geirivtu/NRWD/tmp/vedlegg_nordal_pdcp/test/README.txt

This directory is for unit testing of software modules.
Will not compile on AVR.
