geirivtu/NRWD/doc/notater.txt

Notater av Geir Turtum om NRWD(NTNU Rotation Wrist Device/Norwegian Regent Waving Device)

Kandidater til utviklingsmetodikk
- Top Down Design
