geirivtu/NRWD/doc/Prosjektoppgave/CD/Rapport/Figurer/code_class_diagram.pdf

PDCP representerer
alle filene som
implementerer
protokollen

Diagrammet viser
alle kode modulene
og sammenhengen
mellom de. MAIN

can.h
bool can_init()
can_tx(char, CAN_packet)
prepare_rx(..)

PDCP

analog.h
void analog_init()

motor.h
void motor_init()
void motor_start()
void motor_stop()
void motor_set_speed()
void motor_read_speed()
ISR(TIMER0_OVF_vect)
ISR(HALL_[A,B,C]_vect)

controlller.h
#define TIMESTEP 150

void control_on_off()
void control_position()
void control_speed()
void control_set_setpoint(int16_t) void control_set_parameter(double)

position.h
void position_init()
int16_t position_get()

current.h
#define CURRENT_MAX 145

void current_init()
int16_t current_get()
