geirivtu/NRWD/doc/Kraakenes2011/Rapport/figurer/kapittel 2/kommutering med hall-sensorer.pdf

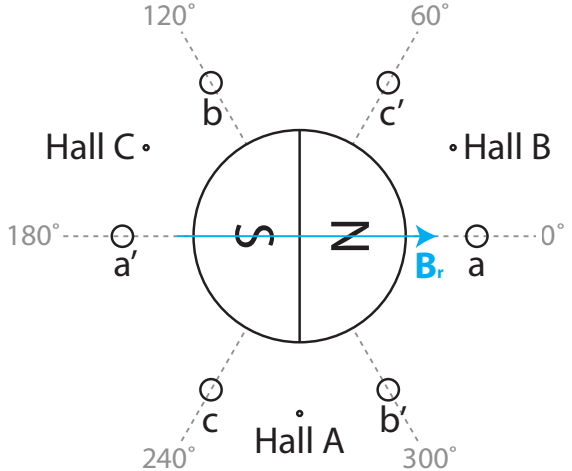
[picture p44: figure]
Hall C; Hall A; Hall B
