geirivtu/NRWD/doc/Kraakenes2011/Rapport/figurer/kapittel 2/motor med hall-sensorer.pdf

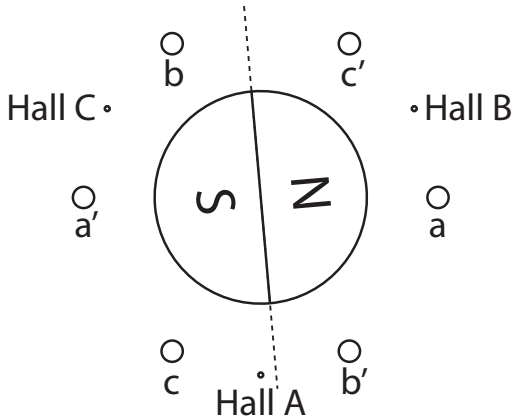
[picture p45: figure]
Hall C; Hall A; Hall B
