geirivtu/NRWD/doc/Kraakenes2011/Rapport/figurer/kapittel 4/arkitektur_maksin.pdf

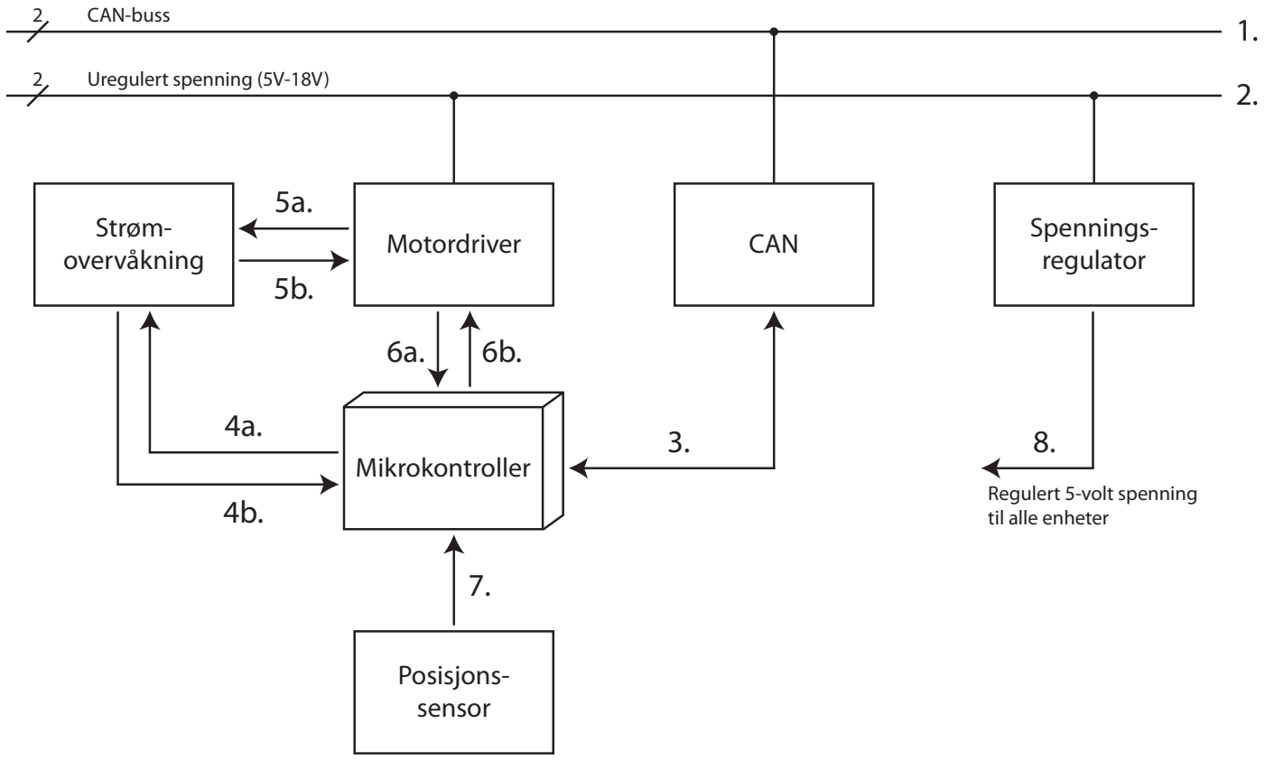
[picture p46: figure]
Spennings- regulator; Strøm-; overvåkning; Motordriver; CAN; Posisjons- sensor; CAN-buss; Uregulert spenning (5V-18V); Mikrokontroller; Regulert 5-volt spenning til alle enheter
