geirivtu/NRWD/doc/Kraakenes2011/Rapport/figurer/kapittel 4/arkitektur_program.pdf

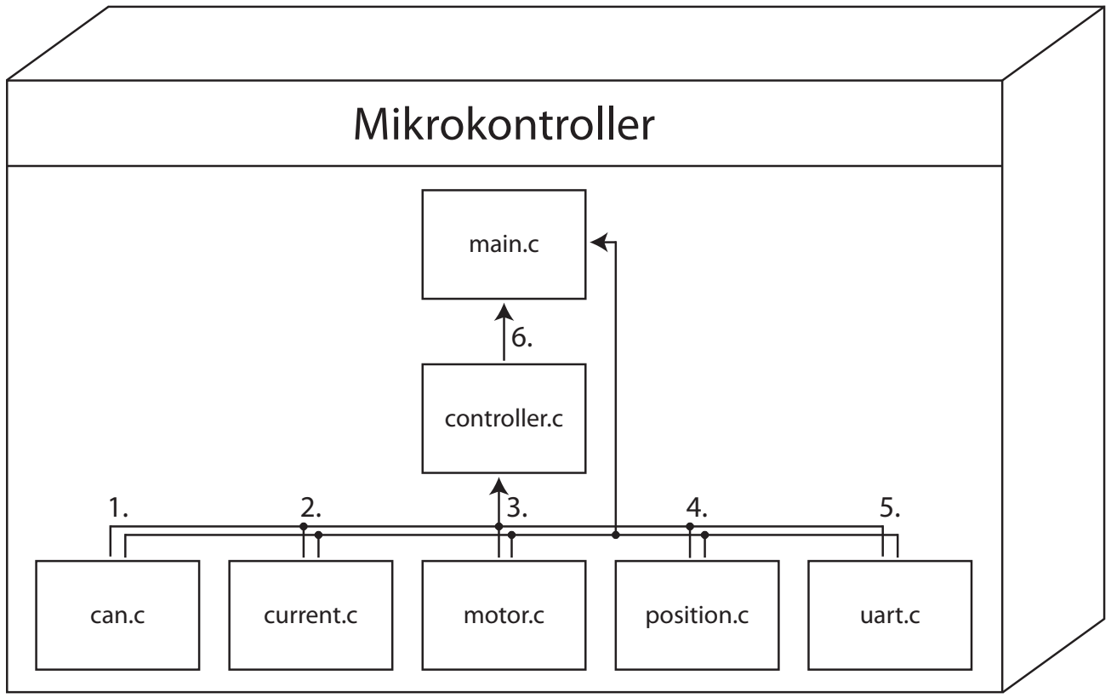
[picture p47: figure]
Mikrokontroller; can.c; current.c; motor.c; position.c; uart.c; controller.c; main.c
