geirivtu/NRWD/doc/Kraakenes2011/Rapport/figurer/kapittel 4/skisse snitt.pdf

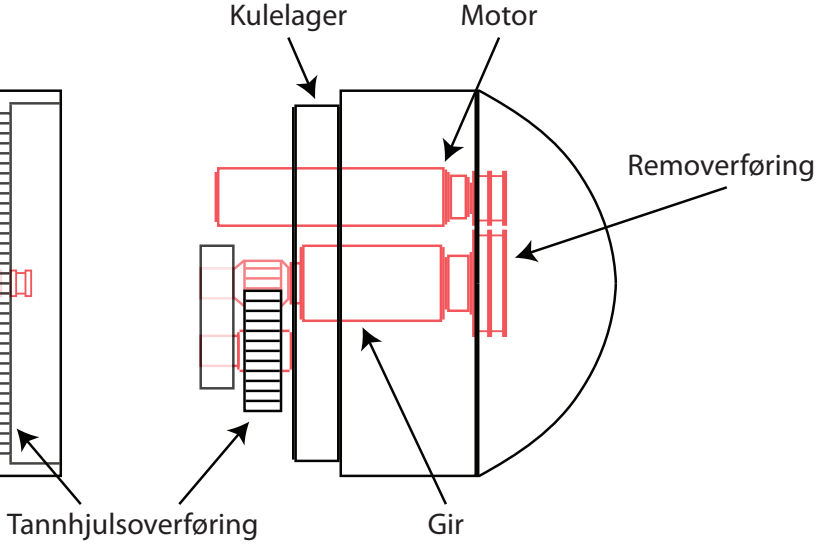
[picture p48: figure]
Motor; Removerføring; Tannhjulsoverføring; Gir; Kulelager
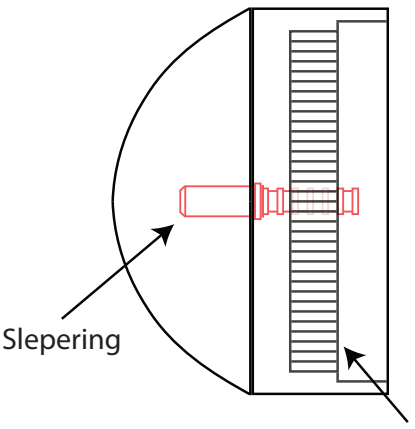
[picture p49: figure]
Slepering
