geirivtu/NRWD/doc/Kraakenes2011/Rapport/figurer/kapittel 5/krets spenning.pdf

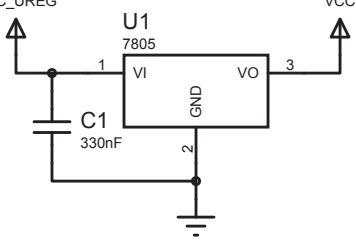
[picture p50: figure]
GND 2

VCC_UR

E

G | VC C
