geirivtu/NRWD/doc/Kraakenes2011/Rapport/figurer/kapittel 6/kommunikasjonsdiagram.pdf

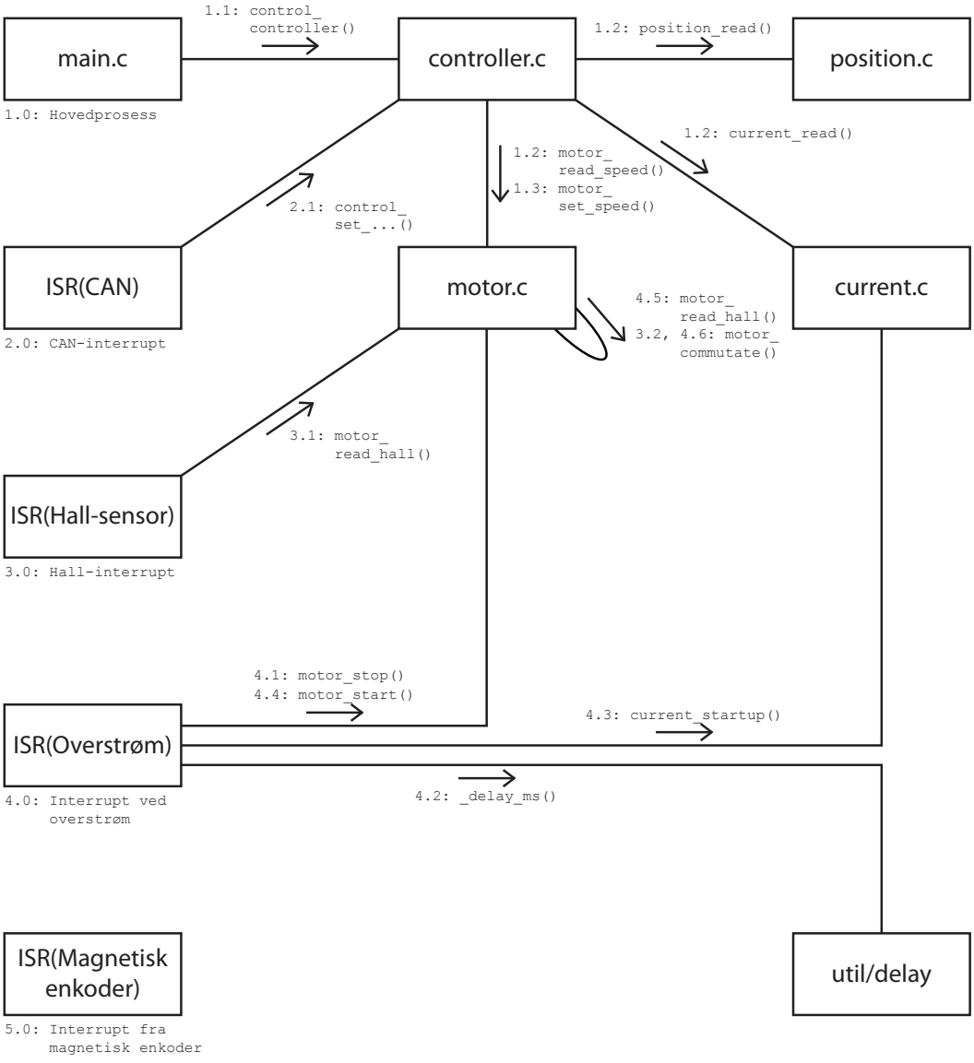
[picture p51: figure]
main.c; ISR(CAN); ISR(Overstrøm); ISR(Magnetisk enkoder); controller.c; position.c; motor.c; current.c; ISR(Hall-sensor); 4.1: motor_stop() 4.4: motor_start(); 1.1: control_ controller(); 3.1: motor_ read_hall(); 4.3: current_startup(); 1.2: position_read(); 1.2: current_read(); 1.2: motor_ read_speed() 1.3: motor_; 2.1: control_; set_speed(); set_...(); 4.2: _delay_ms(); 4.5: motor_ read_hall() 3.2, 4.6: motor_ commutate(); util/delay; 1.0: Hovedprosess; 2.0: CAN-interrupt; 3.0: Hall-interrupt; 4.0: Interrupt ved overstrøm; 5.0: Interrupt fra magnetisk enkoder

### ISR(Motorhastighet)

6.0: Interrupt ved beregning av motorhastighet
