geirivtu/NRWD/doc/Kraakenes2011/Rapport/figurer/kapittel 6/sekvens interrupt can.pdf

CAN-interrupt

main.c | controller.c

## control_ set_mode()

## control_ set_setpoint()

## control_ set_parameter()

[MSG_ID = ID_CONTROLLER]

[MSG_ID = ID_SETPOINT]

[MSG_ID = ID_PARAMETER]

## alt
