geirivtu/NRWD/doc/Kraakenes2011/Rapport/figurer/kapittel 6/sekvens interrupt current.pdf

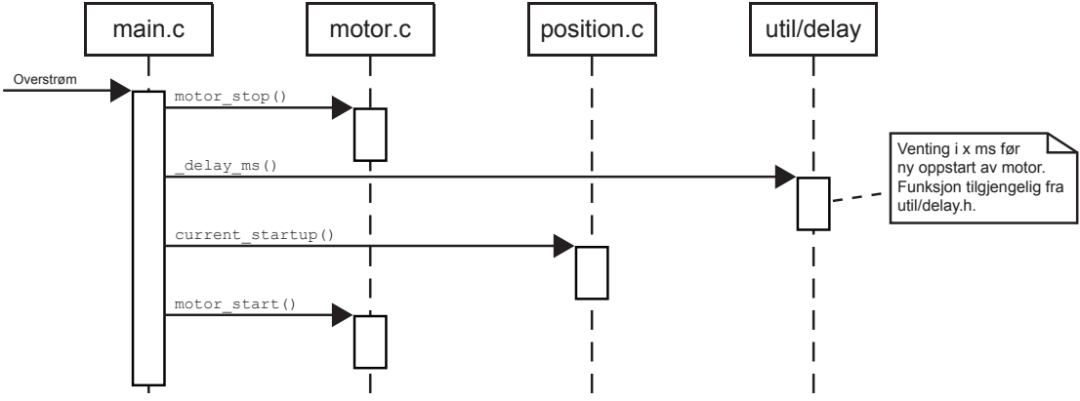
[picture p52: figure]
main.c; motor.c; position.c; Overstrøm; motor_stop(); current_startup(); motor_start(); util/delay; _delay_ms(); Venting i x ms før ny oppstart av motor. Funksjon tilgjengelig fra util/delay.h.
