geirivtu/NRWD/doc/Kraakenes2011/Rapport/figurer/kapittel 6/sekvens interrupt motor.pdf

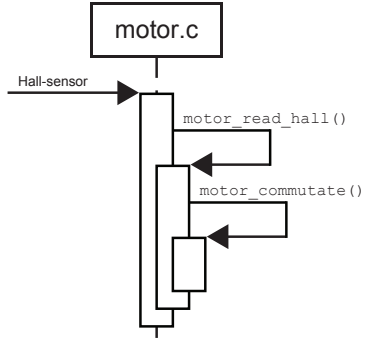
[picture p53: figure]
motor.c; motor_commutate(); motor_read_hall(); Hall-sensor
