geirivtu/NRWD/doc/Kraakenes2011/Rapport/figurer/kapittel 6/sekvensdiagram.pdf

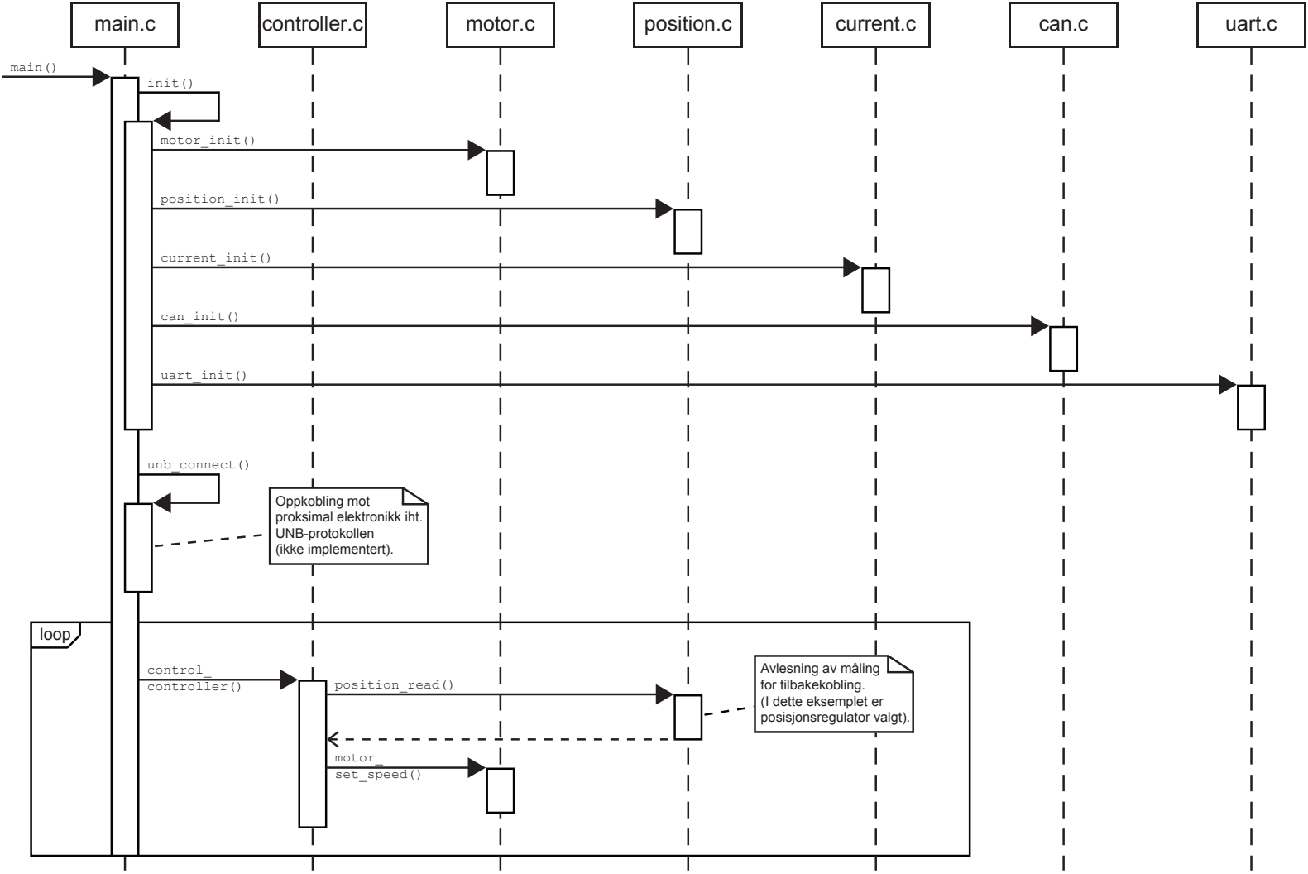
[picture p54: figure]
uart.c; main(); uart_init(); can_init(); current_init(); position_init(); motor_init(); init(); control_; controller(); position_read(); motor_ set_speed(); loop; unb_connect(); Oppkobling mot proksimal elektronikk iht. UNB-protokollen (ikke implementert).; Avlesning av måling for tilbakekobling. (I dette eksemplet er posisjonsregulator valgt).

main.c | controller.c | motor.c | position.c | current.c | can.c
