geirivtu/NRWD/doc/Kraakenes2011/Rapport/figurer/kapittel 2/ideell kommutering.pdf

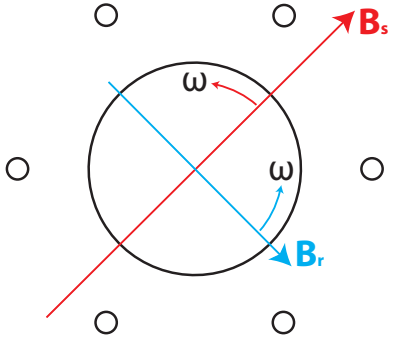
[picture p123: figure]
