geirivtu/NRWD/doc/Kraakenes2011/Rapport/figurer/kapittel 2/kommutering med motindusert spenning.pdf

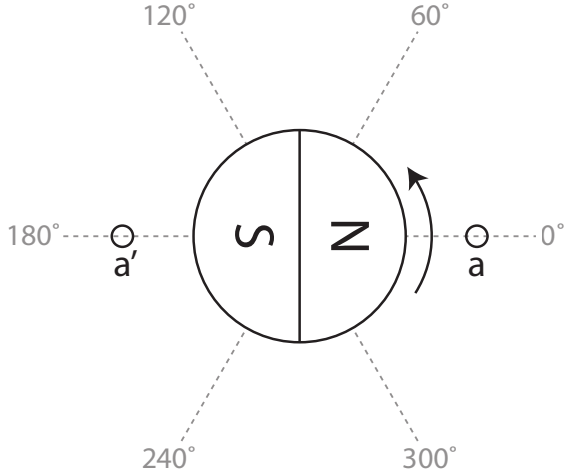
[picture p124: figure]
