geirivtu/NRWD/doc/Kraakenes2011/Rapport/figurer/kapittel 2/stjernekobling.pdf

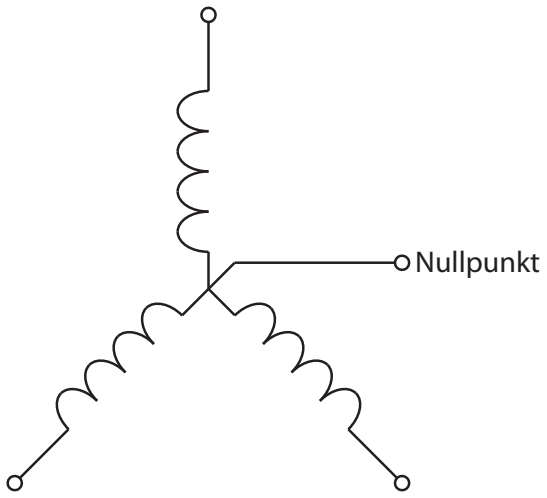
[picture p125: figure]
Nullpunkt

A | B

C
