geirivtu/NRWD/doc/Kraakenes2011/Rapport/figurer/kapittel 2/trefase med en aktiv spole.pdf

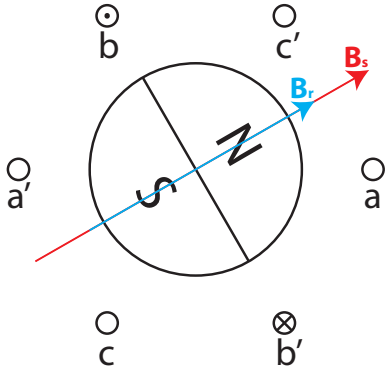
[picture p126: figure]
