geirivtu/NRWD/doc/Kraakenes2011/Rapport/figurer/kapittel 2/trefase med to aktive spoler.pdf

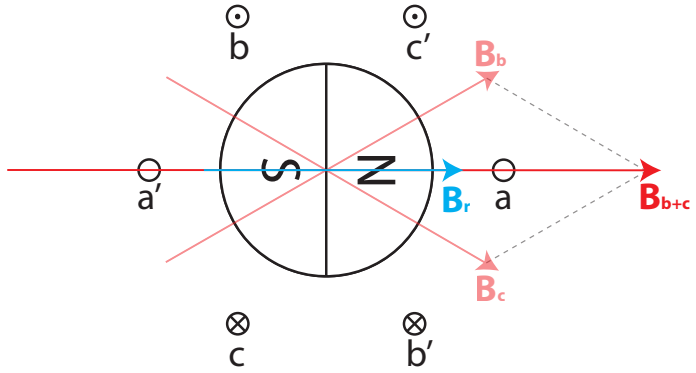
[picture p127: figure]
