geirivtu/NRWD/doc/Kraakenes2011/Rapport/figurer/kapittel 2/trefase.pdf

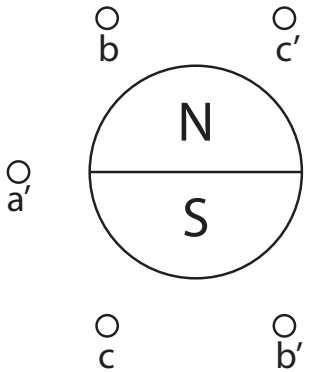
[picture p128: figure]

a
