geirivtu/NRWD/doc/Kraakenes2011/Rapport/figurer/kapittel 4/handledd.pdf

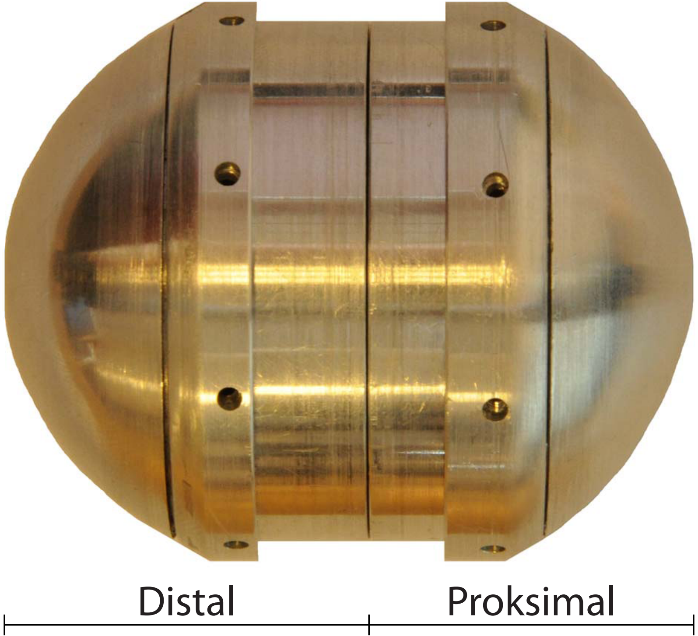
[picture p129: page 1]

Distal | Proksimal
