geirivtu/NRWD/doc/Kraakenes2011/Rapport/figurer/kapittel 5/krets can.pdf

C

A

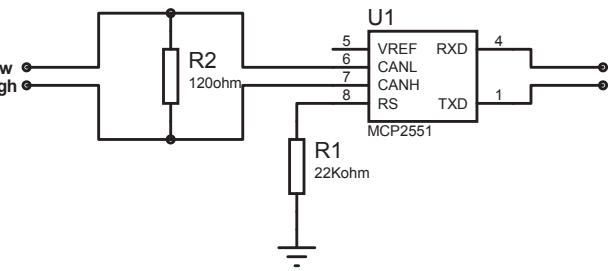
[picture p130: figure]
VRE; CAN; TXD; U1 MCP2551

### N Hig

C

A

### N Lo

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
