geirivtu/NRWD/doc/Kraakenes2011/Rapport/figurer/kapittel 5/krets posisjon.pdf

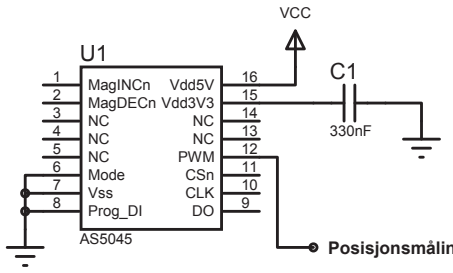
[picture p131: figure]
Mag; INC; Vdd3V3; 15 Vdd5V; MagDEC; Mode; Prog_D; C1 330nF Posis; jons; åli

n

g
