geirivtu/NRWD/doc/Kraakenes2011/Rapport/figurer/vedlegg/magnetholder.pdf

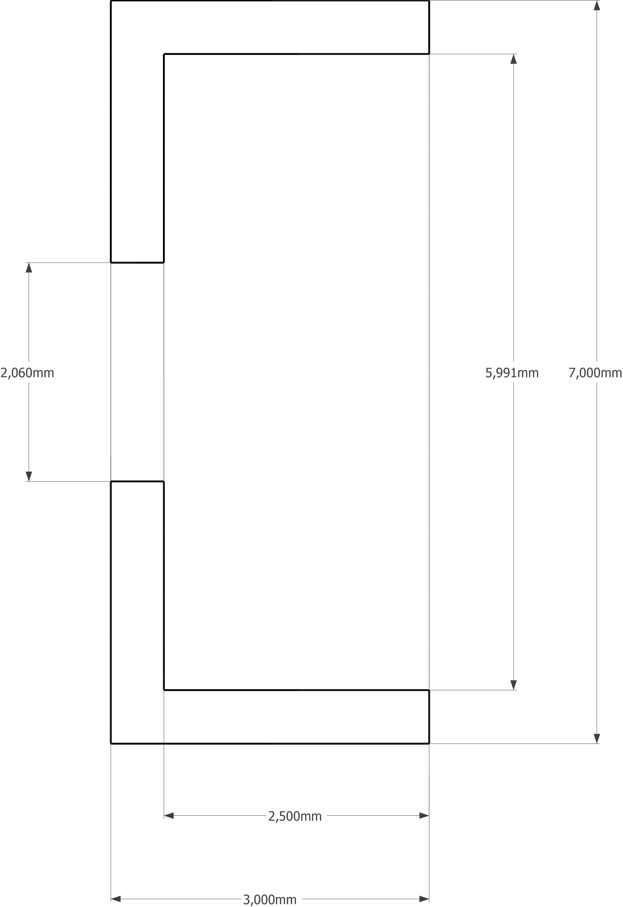
[picture p132: figure]
