geirivtu/NRWD/doc/Storheil.Rainer2005.pdf

NTNU | Fakultet for informasjonsteknologi,
Norges teknisk-naturvitenskapelige | matematikk og elektroteknikk
universitet | Institutt for teknisk kybernetikk

## Prosjektoppgave

Utført ved Institutt for teknisk kybernetikk Veileder: Øyvind Stavdahl

Trondheim, den 17.06.2005

Faglærer: Geir Mathisen

Kandidatens navn: | Rainer Storheil
Fag: | TTK4720 Navigasjon, fartøystyring og robotteknikk, fordypningsemne, Teknisk Kybernetikk
Oppgavens tittel: | Innvevd programvare for kybernetisk håndleddsprotese
Oppgavens tekst: | Forskning har frembrakt ny teoretisk viten om hvordan en motorisert håndleddsprotese bør utformes for å tilby brukeren maksimal nytteverdi. En ønsker å lage en fysisk protese etter disse prinsippene for å evaluere den reelle nytten. Protesen vil ha et mikrokontrollerbasert styresystem, og målet for denne oppgaven er å utvikle og realisere programvaren for systemet basert på en foreliggende funksjonsspesifikasjon.
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
