geirivtu/NRWD/doc/Data/position_sensor_output/max_degree_zomed_in.png

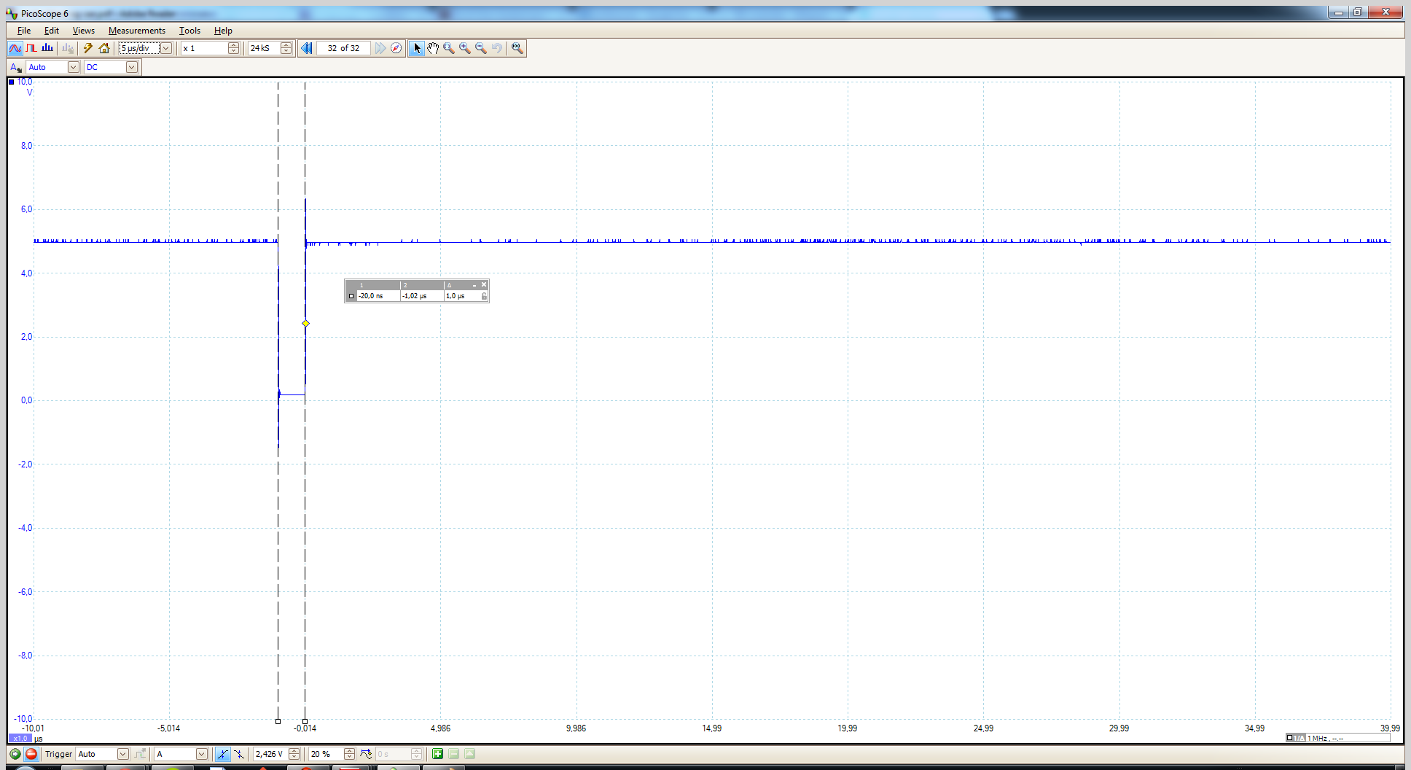
doc/Data/position_sensor_output/max_degree_zomed_in.png
