geirivtu/NRWD/doc/Data/position_sensor_output/min_degree.png

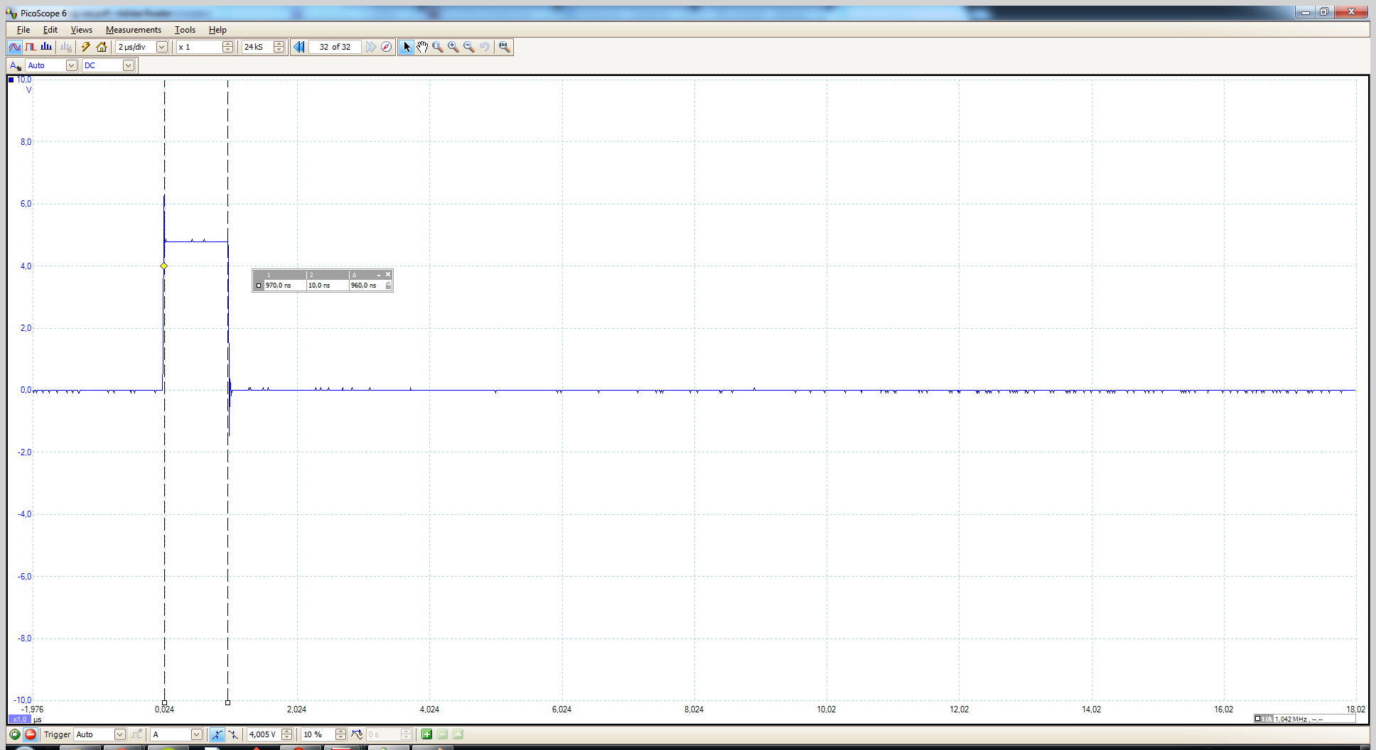
doc/Data/position_sensor_output/min_degree.png
