geirivtu/NRWD/doc/Data/position_sensor_output/whole_period.png

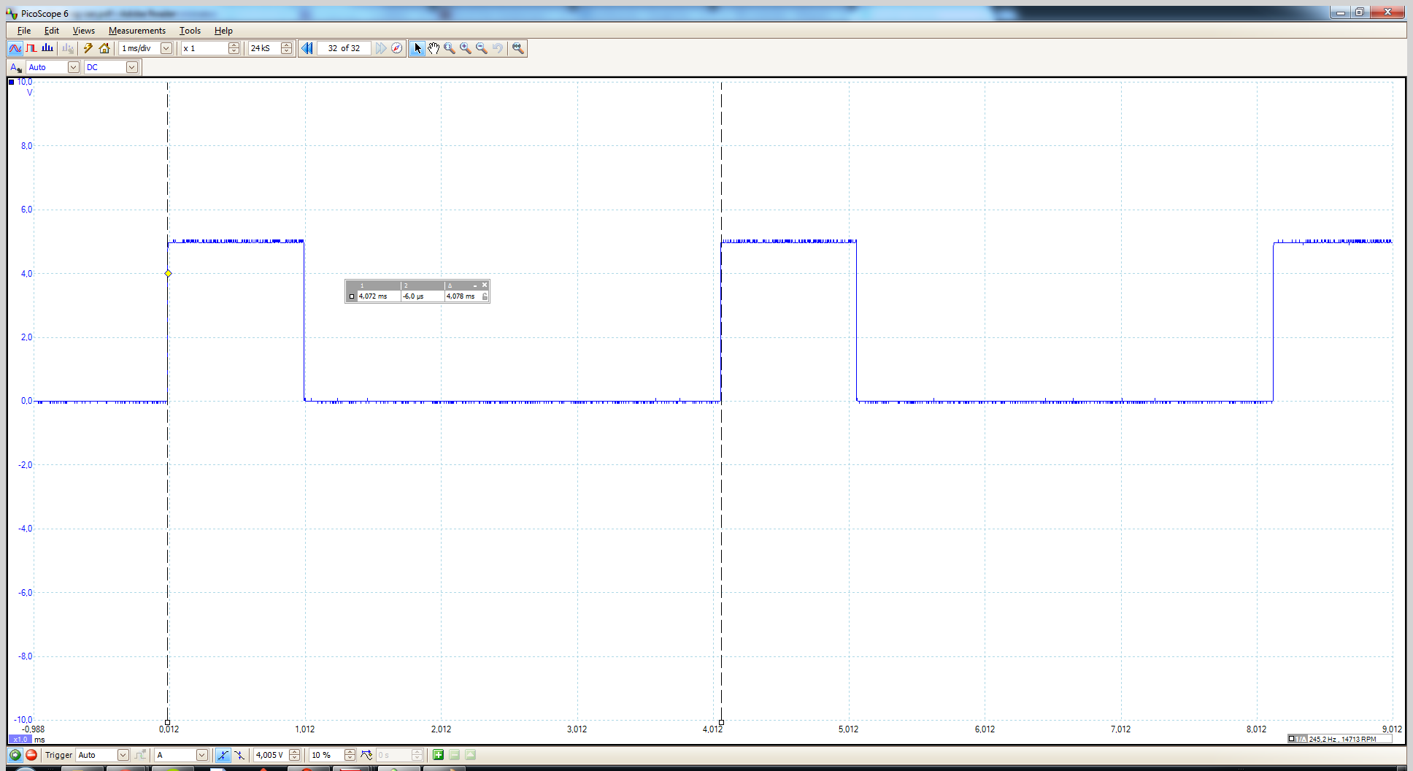
doc/Data/position_sensor_output/whole_period.png
