geirivtu/NRWD/doc/Kraakenes2011/Rapport/figurer/kapittel 6/mikrokontroller.JPG

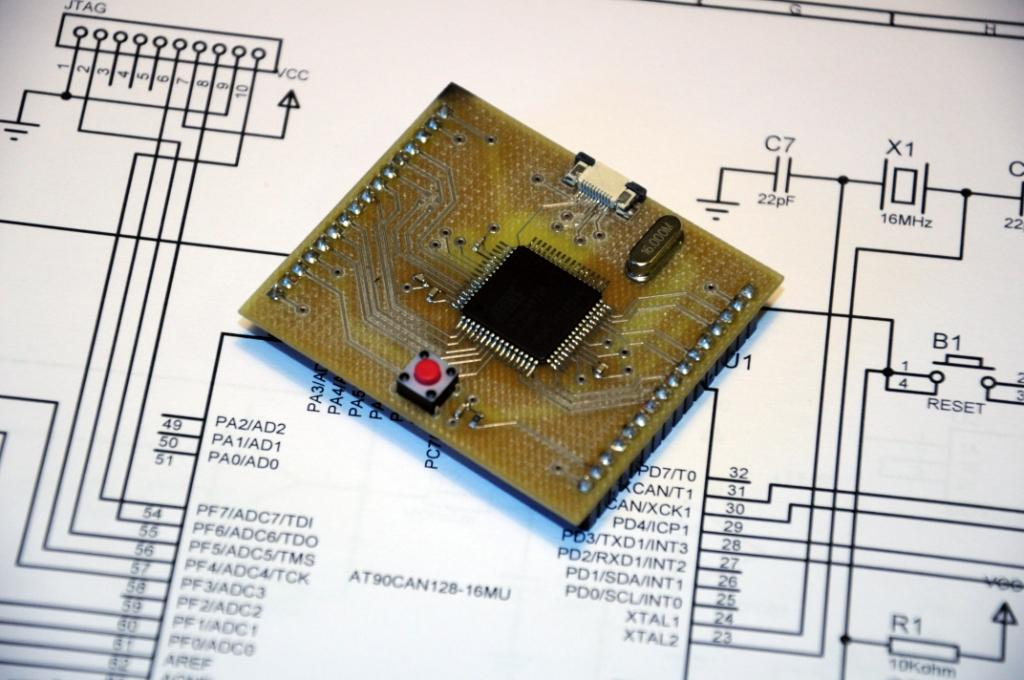
doc/Kraakenes2011/Rapport/figurer/kapittel 6/mikrokontroller.JPG
