geirivtu/NRWD/doc/Kraakenes2011/Rapport/figurer/kapittel 6/motor can.JPG

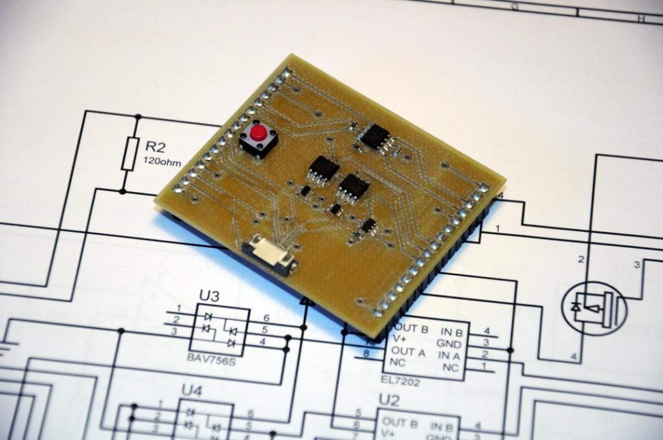
doc/Kraakenes2011/Rapport/figurer/kapittel 6/motor can.JPG
