geirivtu/NRWD/doc/Kraakenes2011/Rapport/figurer/kapittel 6/posisjonssensor håndledd.JPG

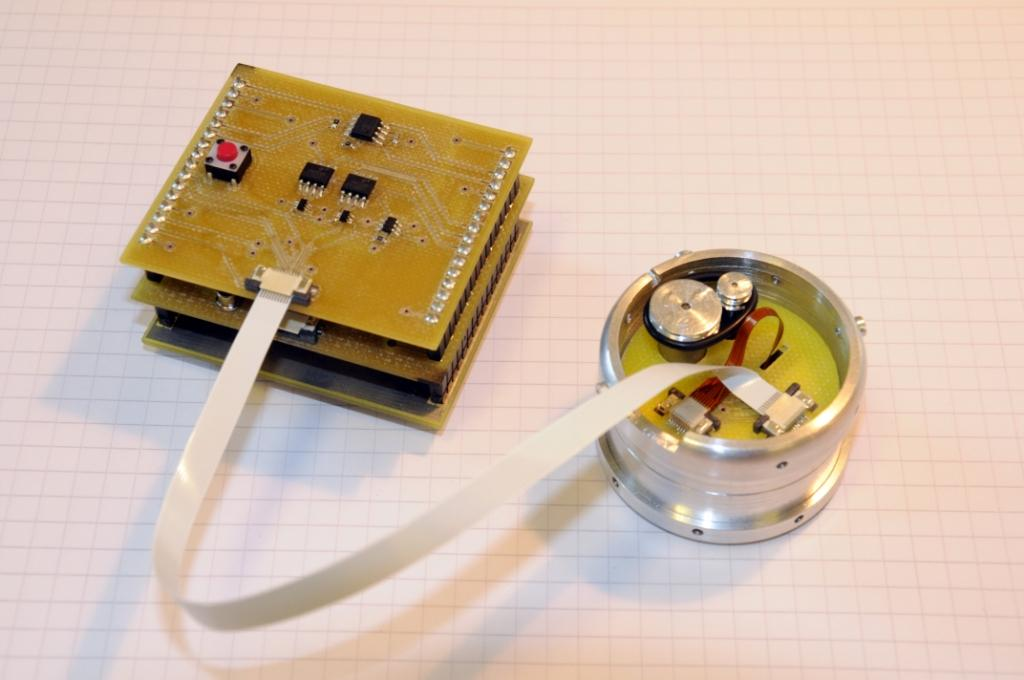
doc/Kraakenes2011/Rapport/figurer/kapittel 6/posisjonssensor håndledd.JPG
