geirivtu/NRWD/doc/Kraakenes2011/Rapport/figurer/kapittel 6/posisjonssensor.JPG

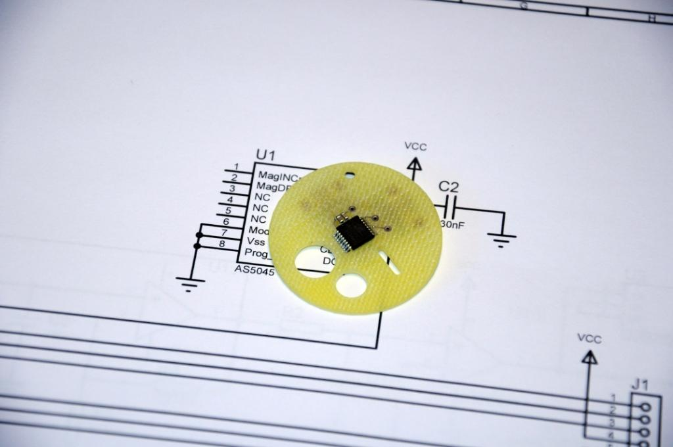
doc/Kraakenes2011/Rapport/figurer/kapittel 6/posisjonssensor.JPG
