geirivtu/NRWD/doc/Kraakenes2011/Rapport/figurer/kapittel 6/spenningsregulator.JPG

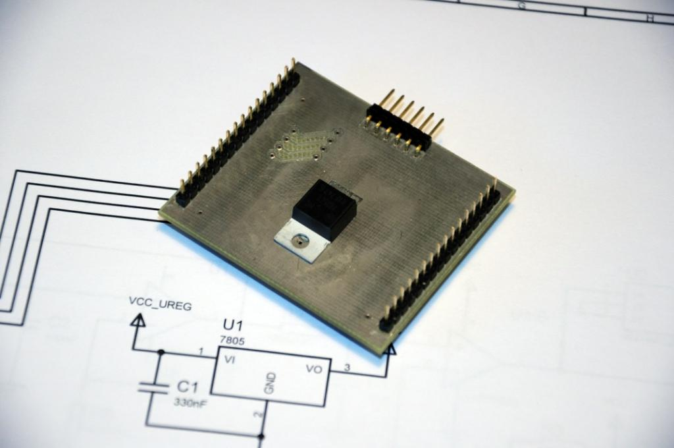
doc/Kraakenes2011/Rapport/figurer/kapittel 6/spenningsregulator.JPG
