geirivtu/NRWD/doc/Kraakenes2011/Rapport/figurer/kapittel 6/strømovervåkning.JPG

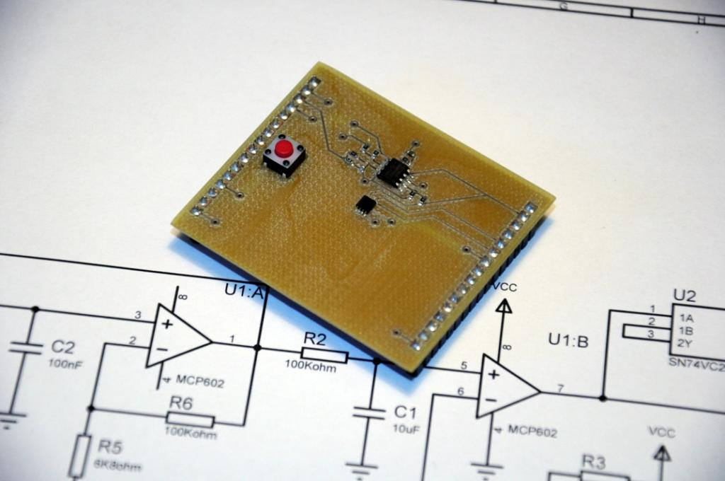
doc/Kraakenes2011/Rapport/figurer/kapittel 6/strømovervåkning.JPG
