geirivtu/NRWD/tmp/vedlegg_nordal_pdcp/doxy-src/interface.png

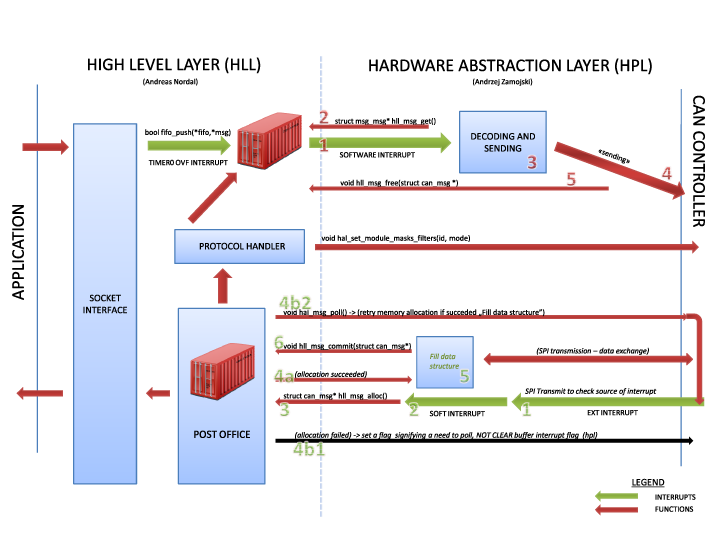
tmp/vedlegg_nordal_pdcp/doxy-src/interface.png
