geirivtu/NRWD/tmp/vedlegg_nordal_pdcp/doxy-src/msgReceiving.png

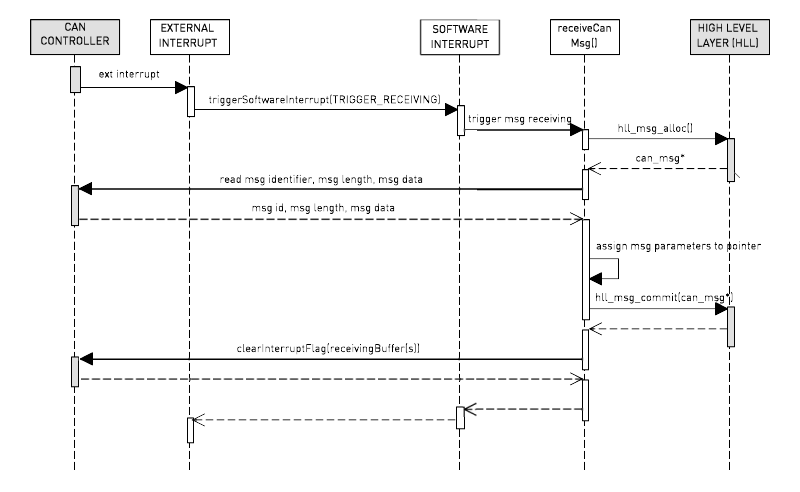
tmp/vedlegg_nordal_pdcp/doxy-src/msgReceiving.png
