geirivtu/NRWD/tmp/vedlegg_nordal_pdcp/doxy-src/msgSending.png

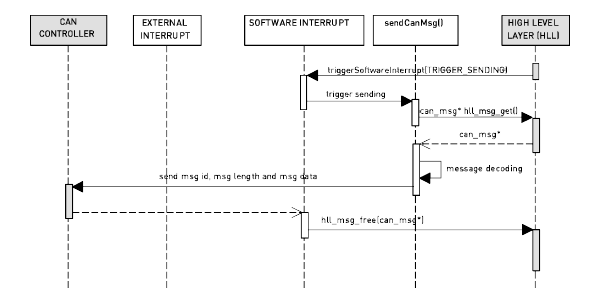
tmp/vedlegg_nordal_pdcp/doxy-src/msgSending.png
