geirivtu/NRWD/tmp/vedlegg_nordal_pdcp/doxy-src/pcbBoard_blockDiagram.png

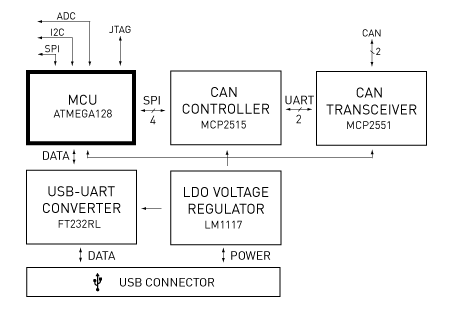
tmp/vedlegg_nordal_pdcp/doxy-src/pcbBoard_blockDiagram.png
