geirivtu/NRWD/(list of files, cad)

Other CAD files:
doc/Kraakenes2011/3D-modell/magnetholder.skp
