geirivtu/NRWD/sw/nrwd_test/pdcp/List_of_functions_to_change.txt

functions.c
	-initCan( uint8_t id);
	-hal_set_filter(id);
	-hal_set_mask(id);
	
irqhandlers.c
	-ISR ( CONFIG_INT_SENDING ) 
	-receiveCanMsg ( uint8_t regRec );
	-sendCanMsg ( struct can_msg* msgToSend, uint8_t regToSend );
