geirivtu/NRWD/doc/Kraakenes2011/Rapport/figurer/kapittel 5/krets motor.pdf

U1
U3

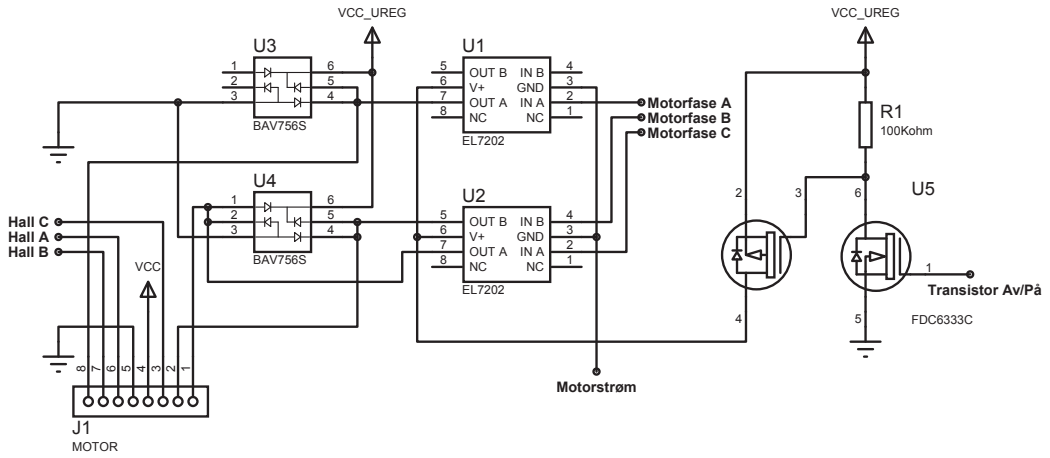
[picture p146: page 1]
1 OUT A 7; 2 GND; 4 OUT B 5; BAV756S; VCC_UREG; Motorfase A; Hall C Hall A Hall B; Motorfase B Motorfase C; J1 MOTOR; FDC6333C; R1 100Kohm; Transistor Av/På; Motorstrøm; VCC
