geirivtu/NRWD/doc/Kraakenes2011/Rapport/figurer/vedlegg/krets motordriver og can.pdf

U5
R2

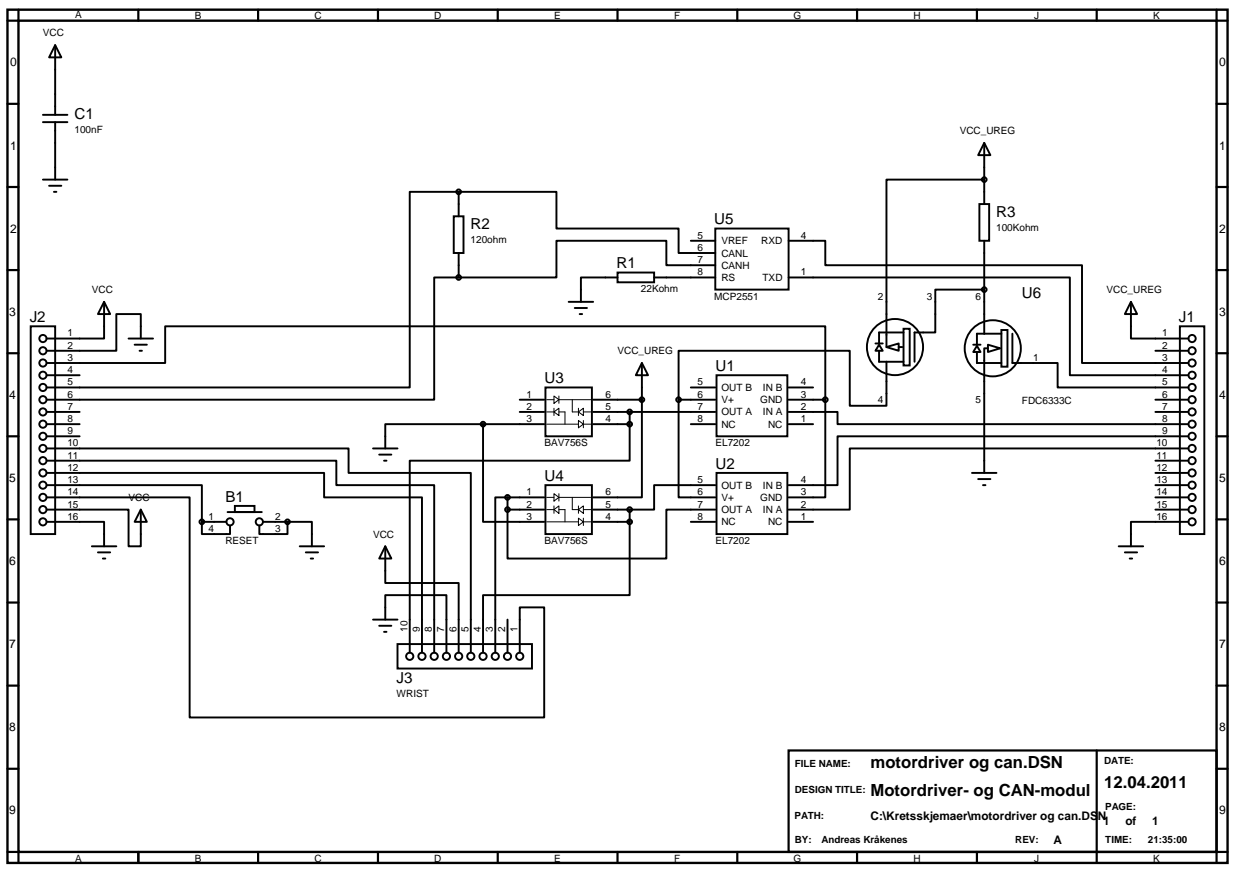
[picture p147: page 1]

motordriver og can.DSN FILE NAME: DESIGN TITLE: Motordriver- og CAN-modul C:\Kretsskjemaer\motordriver og can.DSN1 of 1 BY: Andreas Kråkenes REV: A | DATE: 12.04.2011 PAGE: TIME: 21:35:00 | 9 PATH:
