geirivtu/NRWD/doc/Kraakenes2011/Rapport/figurer/vedlegg/krets posisjonsmåling.pdf

C1

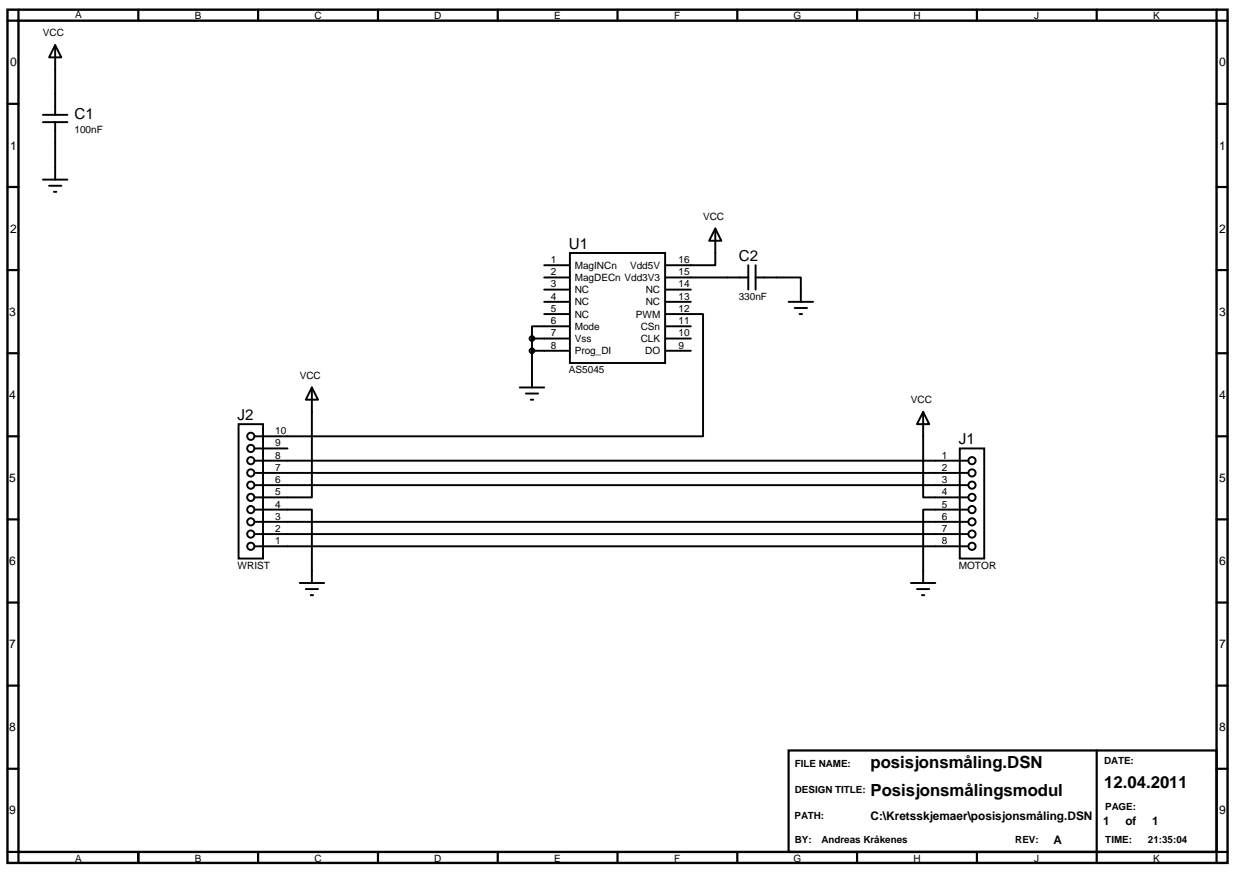
[picture p148: page 1]
MagINCn 1; Vdd3V3; 15 Vdd5V; 14 MagDECn 2; NC 5 Mode 6 Vss 7 Prog_DI 8; CSn; 11 PWM; CLK; VCC; WRIST; MOTOR

0 | | VCC | 0

posisjonsmåling.DSN FILE NAME: DESIGN TITLE: Posisjonsmålingsmodul C:\Kretsskjemaer\posisjonsmåling.DSN BY: Andreas Kråkenes REV: A | DATE: 12.04.2011 PAGE: 1 of 1 TIME: 21:35:04 | 9 PATH:
