geirivtu/NRWD/doc/Kraakenes2011/Rapport/figurer/vedlegg/krets spenningsregulator.pdf

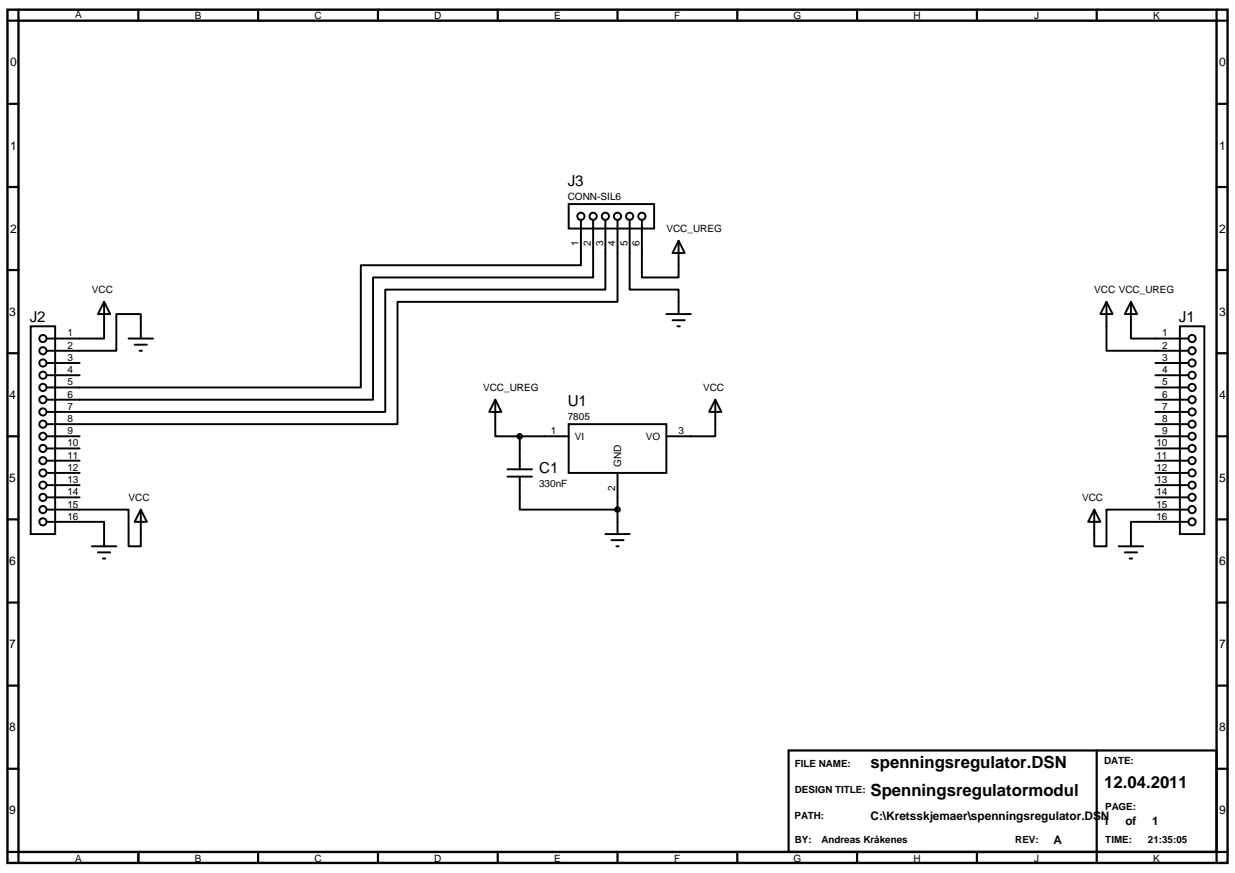
[picture p149: page 1]
VCC; VCC VCC_UREG; GND; VCC_UREG

0 | J3 CONN-SIL6 | | | | | | | | | | 0

spenningsregulator.DSN FILE NAME: DESIGN TITLE: Spenningsregulatormodul C:\Kretsskjemaer\spenningsregulator.DSN1 of 1 BY: Andreas Kråkenes REV: A | DATE: 12.04.2011 PAGE: TIME: 21:35:05 | 9 PATH:
