geirivtu/NRWD/tmp/vedlegg_nordal_pdcp/doc/interfaceLayout.pdf

# HIGH LEVEL LAYER (HLL) HARDWARE ABSTRACTION LAYER (HPL)

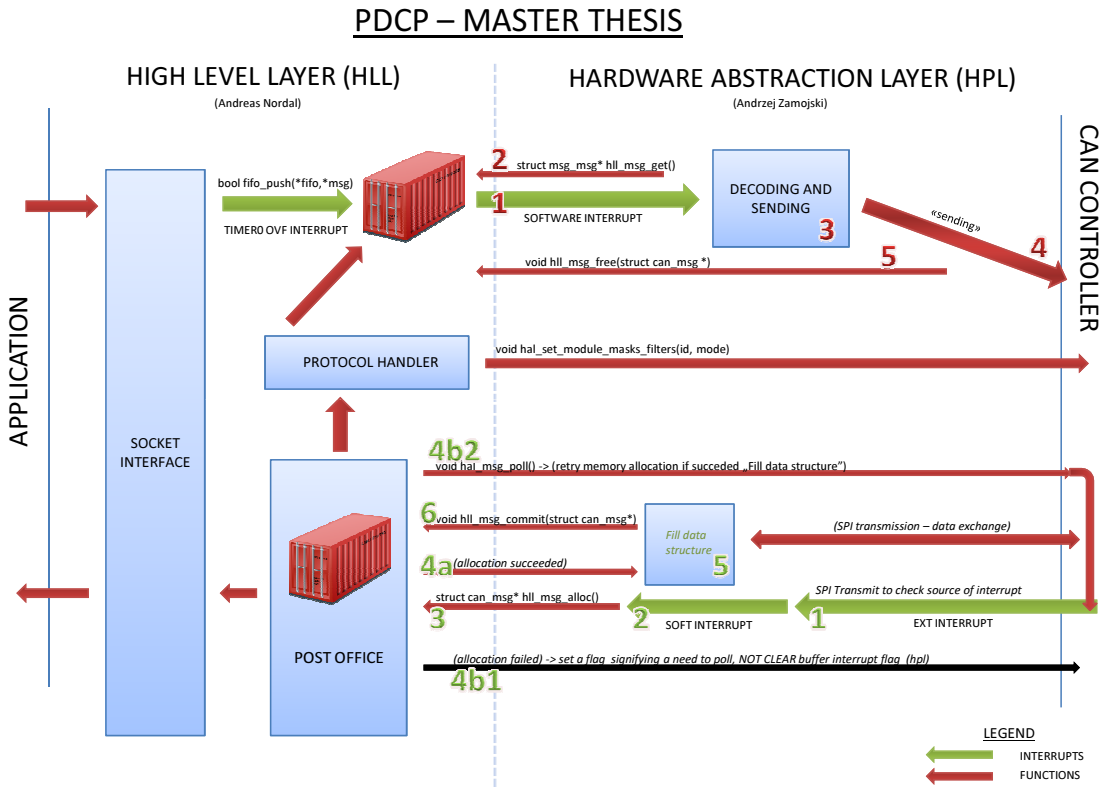
[picture p150: page 1]
void hll_msg_free(struct can_msg *); (Andreas Nordal); (Andrzej Zamojski); SOCKET; INTERFACE; EXT INTERRUPT; APPLICATION; LEGEND; INTERRUPTS; FUNCTIONS; struct can_msg* hll_msg_alloc(); Fill data structure; (allocation succeeded); void hll_msg_commit(struct can_msg*); POST OFFICE; SOFT INTERRUPT

PDCP – MASTER THESIS

CAN CONTROLLER bool fifo_push(*fifo,*msg) TIMER0 OVF INTERRUPT SOFTWARE INTERRUPT struct msg_msg* hll_msg_get() DECODING AND SENDING

void hal_set_module_masks_filters(id, mode) PROTOCOL HANDLER

void hal_msg_poll() -> (retry memory allocation if succeded „Fill data structure”)

(SPI transmission – data exchange)

SPI Transmit to check source of interrupt

(allocation failed) -> set a flag signifying a need to poll, NOT CLEAR buffer interrupt flag (hpl)
