geirivtu/NRWD/doc/Kraakenes2011/Rapport/figurer/kapittel 1/v-modell.pdf

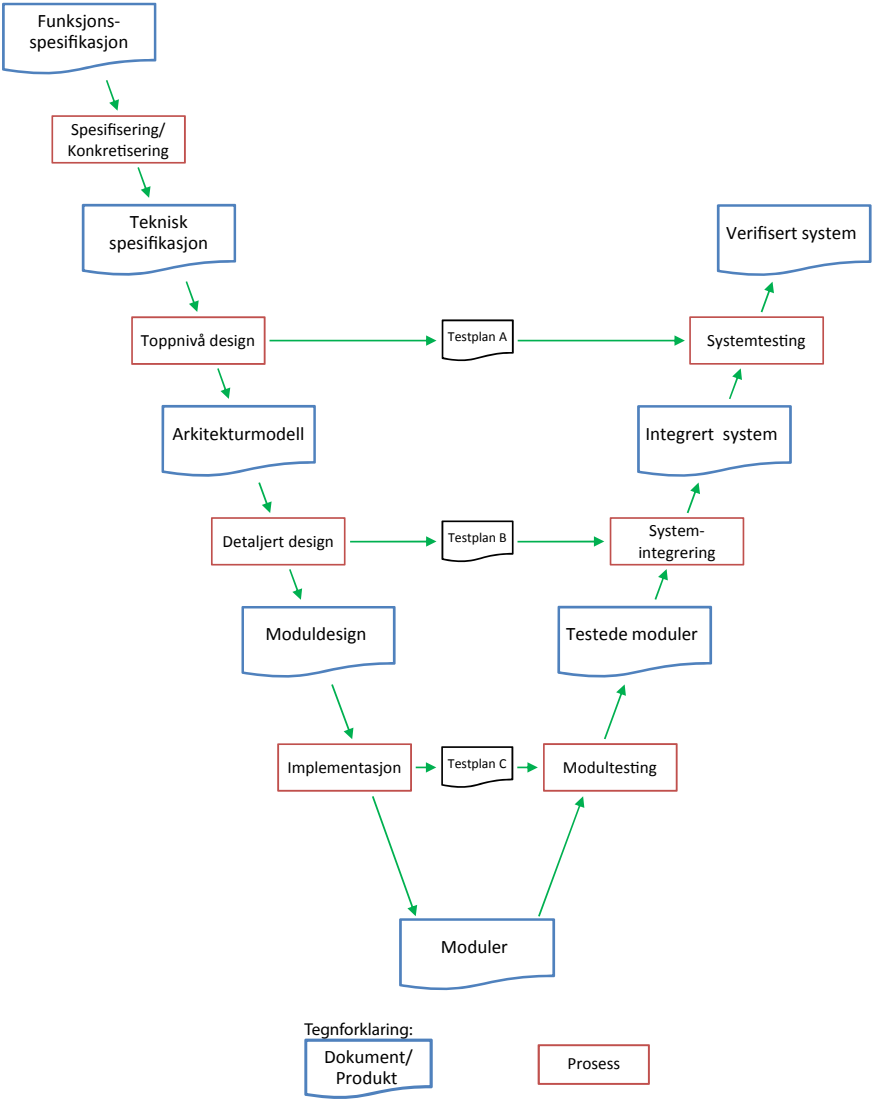
[picture p151: page 1]
Moduler; Moduldesign; Arkitekturmodell; Testede moduler; Integrert system; Verifisert system; Toppnivå design; Detaljert design; Implementasjon; Modultesting; System- integrering; Systemtesting; Testplan C; Testplan B; Testplan A; Teknisk spesifikasjon; Spesifisering/ Konkretisering; Funksjons- spesifikasjon; Dokument/ Produkt; Prosess; Tegnforklaring:
