geirivtu/NRWD/doc/Kraakenes2011/Rapport/figurer/kapittel 1/vinkling av håndledd.pdf

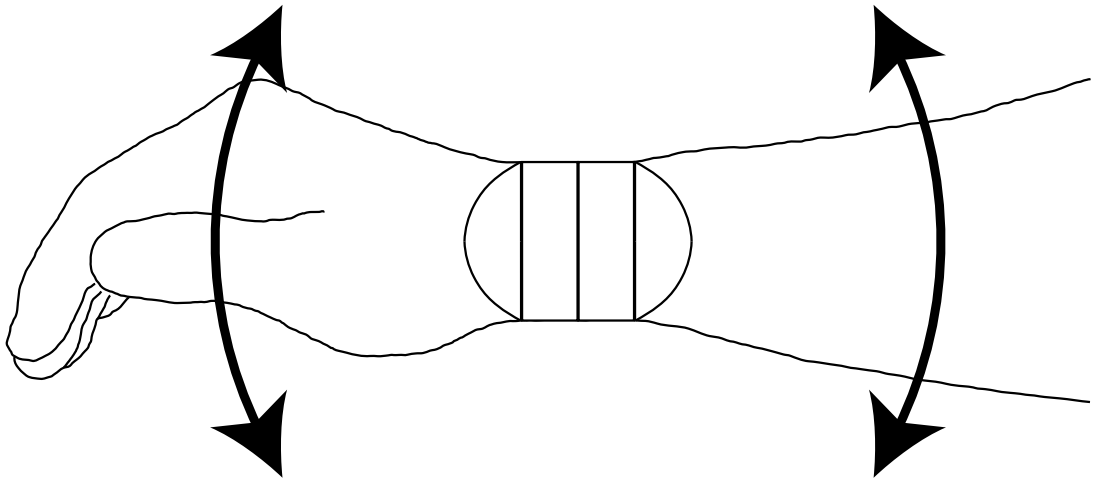
[picture p152: page 1]
