geirivtu/NRWD/doc/Kraakenes2011/Rapport/figurer/kapittel 2/deltakobling.pdf

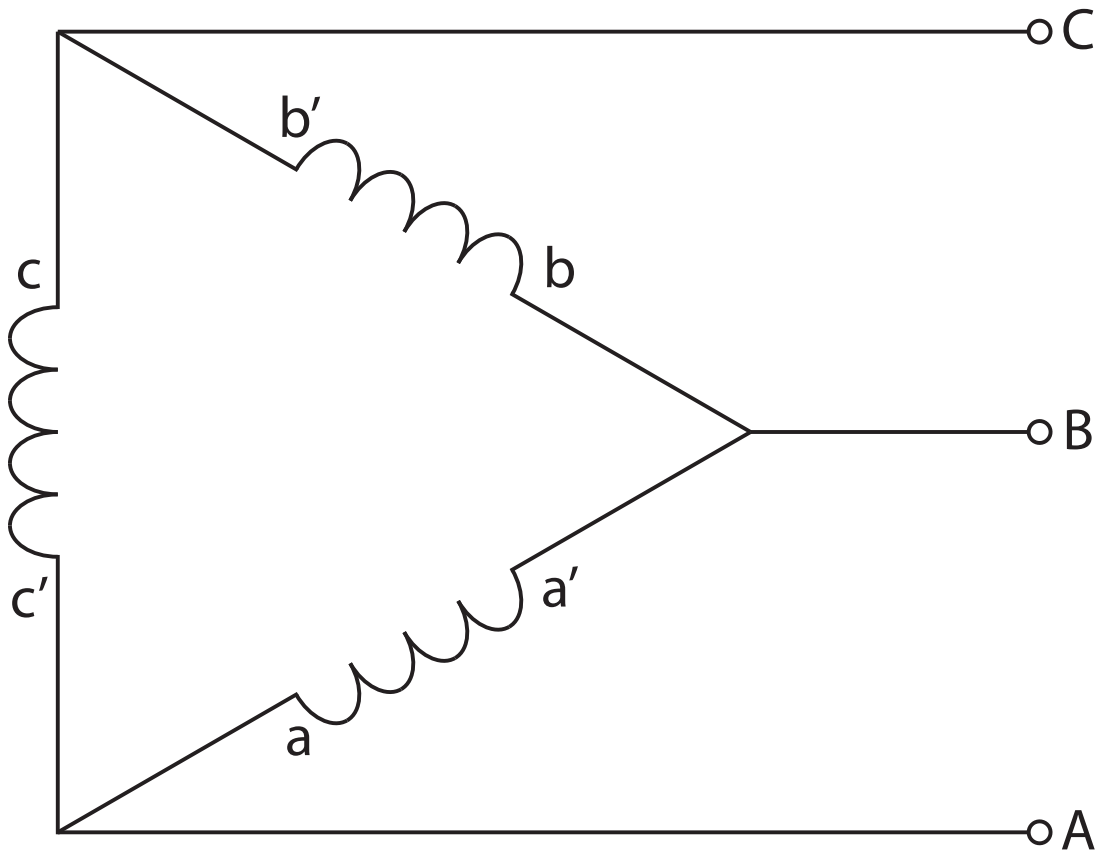
[picture p153: page 1]
