geirivtu/NRWD/doc/Kraakenes2011/Rapport/figurer/kapittel 5/krets mcu.pdf

J1

U1

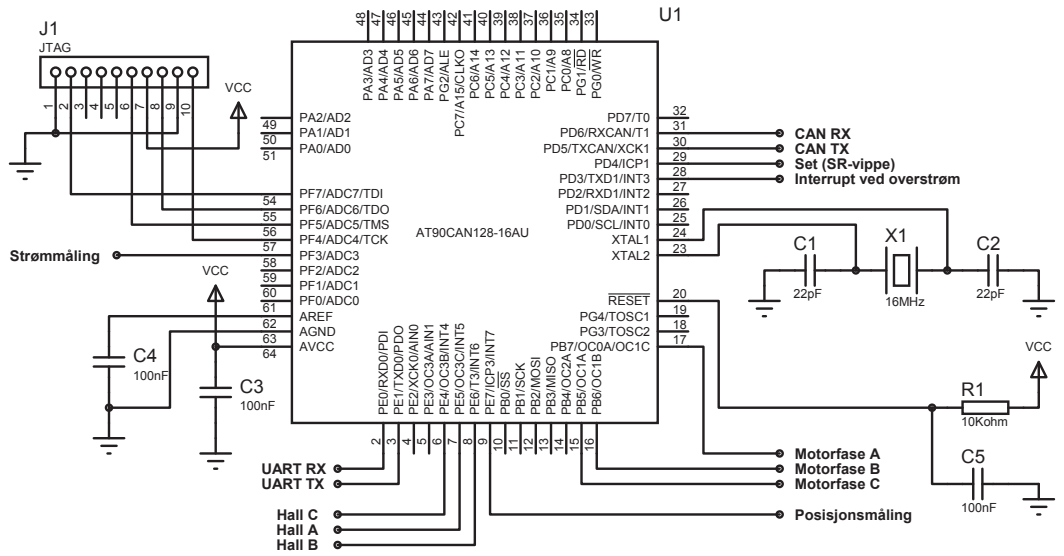
[picture p154: page 1]
JTAG; VCC; PB1/SCK 11; PB2/MOSI 12 PB3/MISO 13; AREF 62; AVCC 64; AGND 63; XTAL1; XTAL2; RESET; PG2/ALE 43; WR 33 PG1/RD 34 PG4/TOSC1 19; PG3/TOSC2; PE0/RXD0/PDI 2; PE1/TXD0/PDO 3; PE2/XCK0/AIN0 4; PE3/OC3A/AIN1 5 PE4/OC3B/INT4 6; PE5/OC3C/INT5 7; PE6/T3/INT6 8; PE7/ICP3/INT7 9; PD0/SCL/INT0; 25 PD1/SDA/INT1; 26 PD2/RXD1/INT2; 27 PD3/TXD1/INT3; 28 PD4/ICP1; 29 PD5/TXCAN/XCK1; 30 PD6/RXCAN/T1; PF0/ADC0 61; PF1/ADC1 60; PF2/ADC2 59; PF3/ADC3 58; PF4/ADC4/TCK 57; PF5/ADC5/TMS 56; PF6/ADC6/TDO 55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

CAN RX
CAN TX
Set (SR-vippe)
Interrupt ved overstrøm
