geirivtu/NRWD/doc/Kraakenes2011/Rapport/figurer/kapittel 5/krets strøm.pdf

U2

U1:A

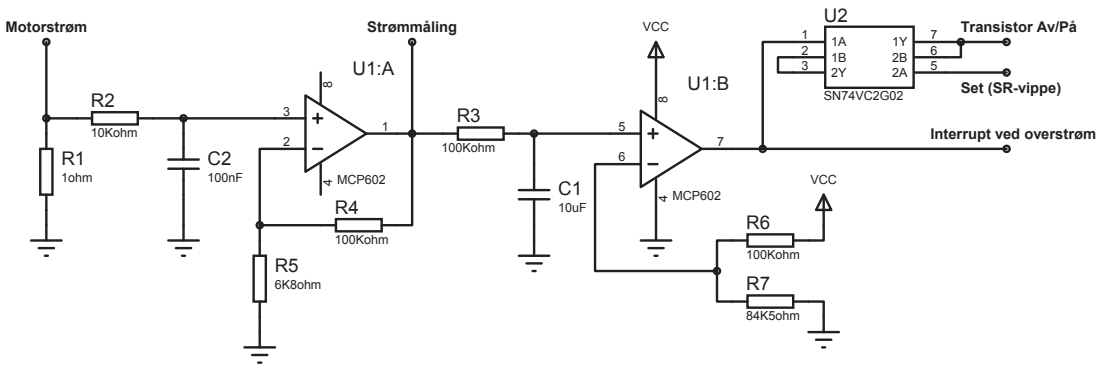
[picture p155: page 1]
