geirivtu/NRWD/doc/Kraakenes2011/Rapport/figurer/kapittel 5/magnetholder.pdf

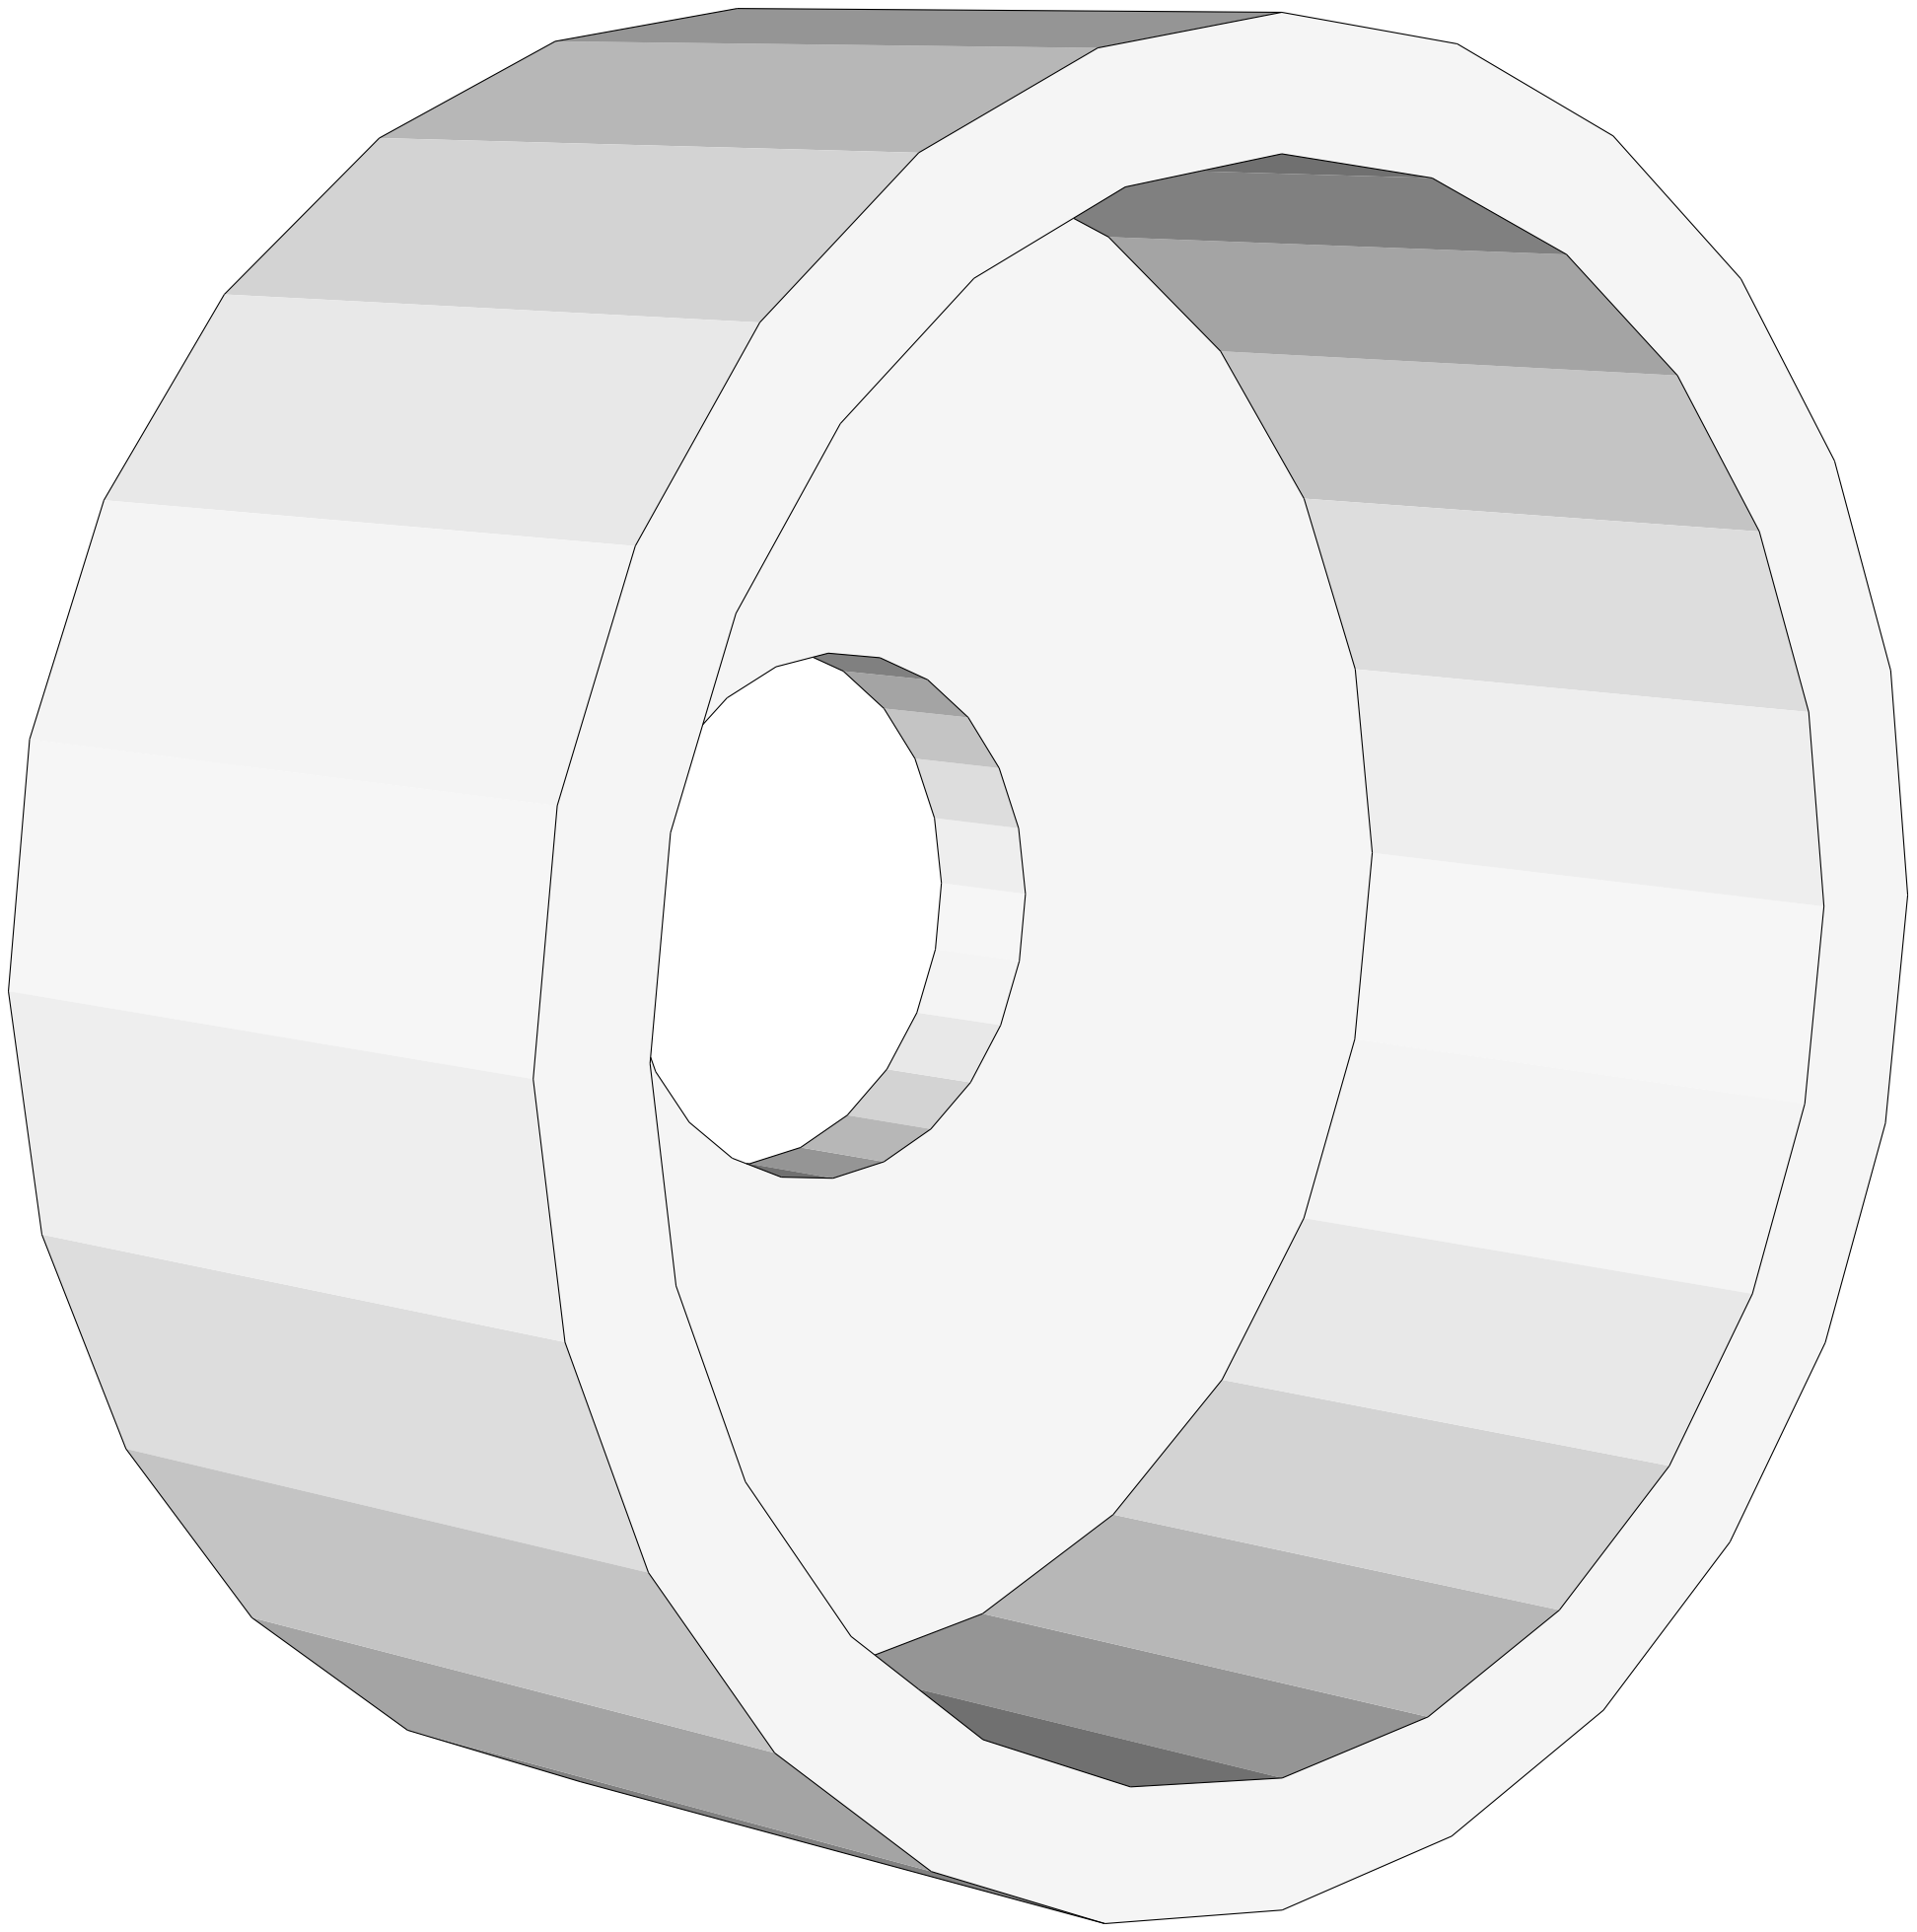
[picture p156: page 1]
