geirivtu/NRWD/doc/Kraakenes2011/Rapport/figurer/kapittel 5/sleperingkontakt med holder.pdf

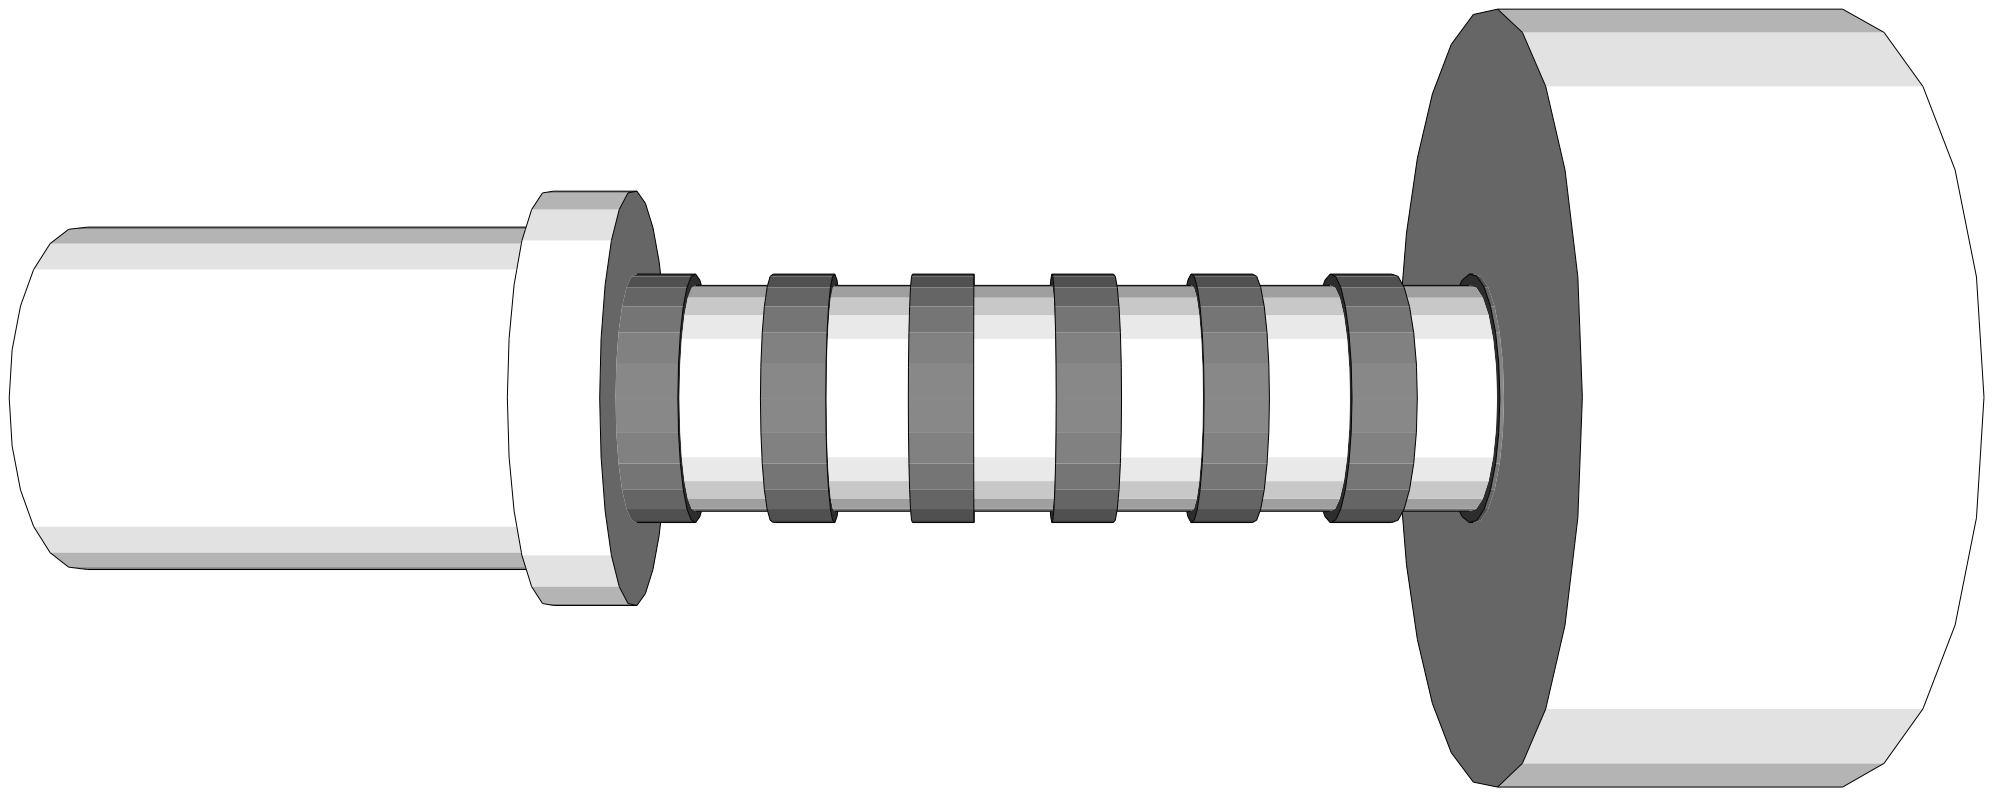
[picture p157: page 1]
