geirivtu/NRWD/doc/Kraakenes2011/Rapport/figurer/vedlegg/krets mikrokontroller.pdf

J3

C2

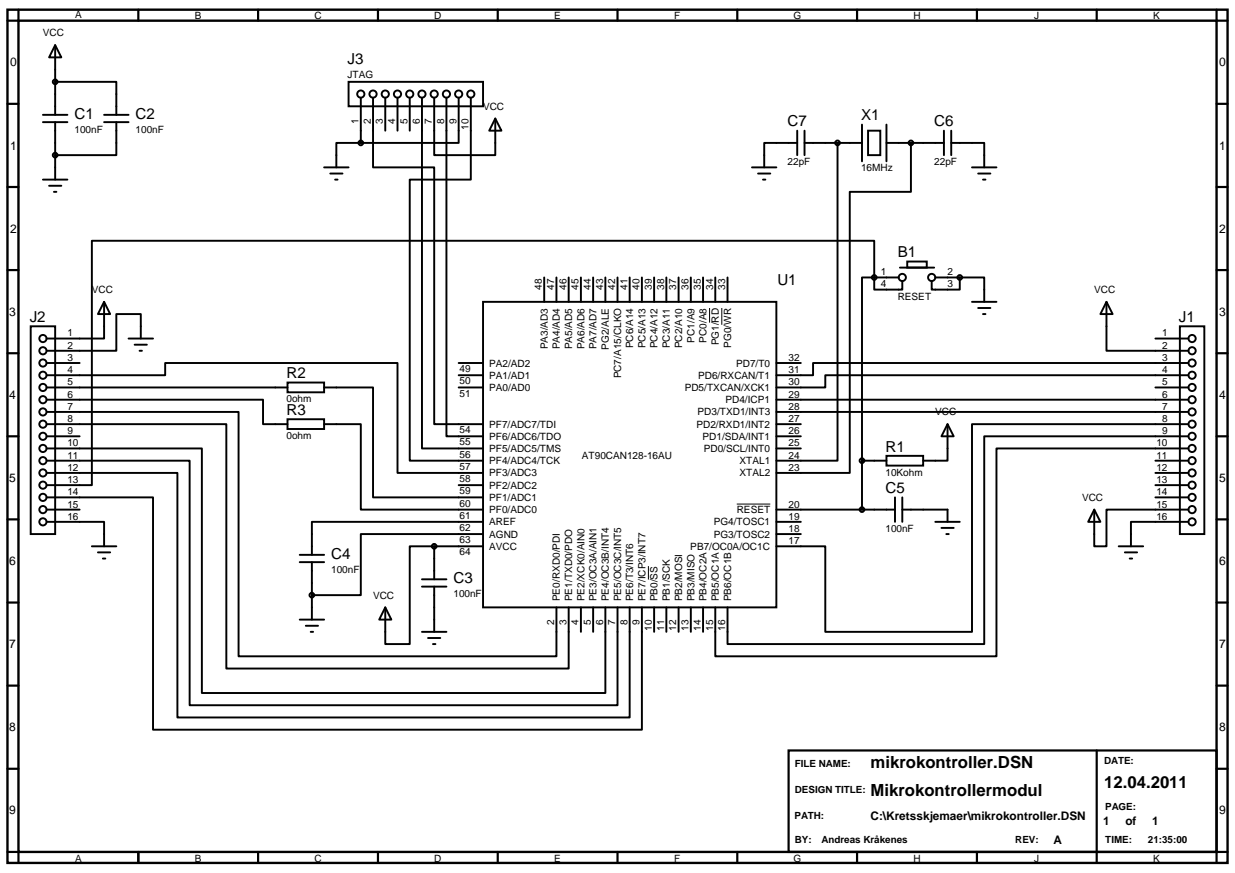
[picture p158: page 1]

mikrokontroller.DSN FILE NAME: DESIGN TITLE: Mikrokontrollermodul C:\Kretsskjemaer\mikrokontroller.DSN BY: Andreas Kråkenes REV: A | DATE: 12.04.2011 PAGE: 1 of 1 TIME: 21:35:00 | 9 PATH:
