geirivtu/NRWD/doc/Kraakenes2011/Rapport/figurer/vedlegg/krets strømovervåkning.pdf

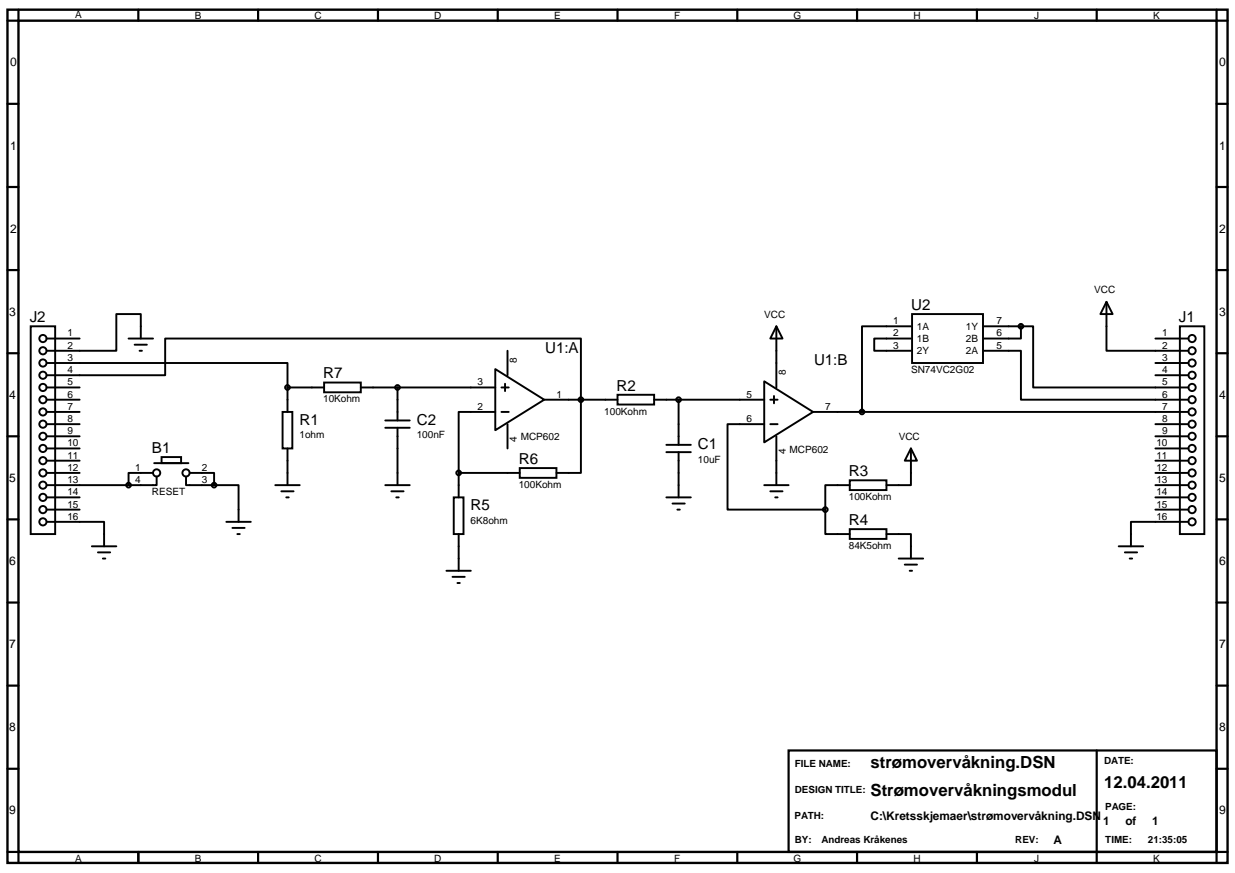
[picture p159: page 1]

strømovervåkning.DSN FILE NAME: DESIGN TITLE: Strømovervåkningsmodul C:\Kretsskjemaer\strømovervåkning.DSN 1 of 1 BY: Andreas Kråkenes REV: A | DATE: 12.04.2011 PAGE: TIME: 21:35:05 | 9 PATH:
