geirivtu/NRWD/doc/Prosjektoppgave/CD/Programvare/nrwd/current.c

#include <avr/io.h>
#include <avr/interrupt.h>
#include <util/delay.h>

#include "current.h"

 
void current_init(void)
{
	DDRD |= (1<<PD4);

	/* Enabling interrupt on PD3 */
	EICRA |= (1<<ISC30) | (1<<ISC31);
	EIMSK |= (1<<INT3);

	/* Setting ADC reference voltage to AVCC with external capacitor on AREF pin  */
	ADMUX = (1<<REFS0);
	
	/* Enabling ADC */
	ADCSRA = (1<<ADEN);
	
	current_startup();
}

void current_startup(void)
{
	/* Toggling set-pin on SR-latch */
	PORTD |= (1<<PD4);
	_delay_us(1);
	PORTD &= ~(1<<PD4);
}


/* Returns current in mA */ 
uint16_t current_read(void)
{
	uint16_t current_mA = 0;
	
	/* Multiply K with ADC value to get current in 1/10 uA 
	* ADCref = 5 V
	* Aopamp = 15.7 (opamp gain)
	* K = ADCref * (100'000/1024)/(Aopamp) = 31
	*/
	uint16_t K = 31; 
	
	/* Choosing channel ADC3, output from the OPAMP where 2.28V equals the max current of 145 mA  */
	ADMUX &= 0b11100000 | 3;

	/* Starting conversion */
	ADCSRA |= (1<<ADSC);

	/* Waiting for 10 bit ADC conversion to complete */
	while (!(ADCSRA & (1<<ADIF)));
	/* Clear conversion complete flag */
	ADCSRA &= ~(1<<ADIF);

	current_mA = (K*ADC)/100;

	return current_mA;
}
