geirivtu/NRWD/doc/Prosjektoppgave/CD/Programvare/nrwd/pdcp/types.h

/**
 * @file    types.h
 * @brief
 * @details
 * @author  Andreas Nordal @n NTNU in Trondheim (NORWAY)
 * @date    spring 2012
 */

#ifndef TYPES_H
#define TYPES_H

#include <stdint.h>

/* 
 * These type names are used in the Linux kernel.
 * Andreas likes them.
 */
typedef uint8_t u8;
typedef uint16_t u16;

#endif
