geirivtu/NRWD/(commit log)

2013-09-03 Add docs
    [magnetholder.skp]
2013-10-14 current.c update
2013-11-05 analog interrupt working
2013-11-13 cascade pid
2013-12-03 nrwd prototype bilde lagt ved
